hnz1102/EEW-display/hw/BOM.csv

Reference | Qty | Value | DNP | Footprint | digikey/other
C1,C10 | 2 | 1uF |  | Capacitor_SMD:C_0805_2012Metric | 1276-1026-1-ND
C2,C3 | 2 | 16pF |  | Capacitor_SMD:C_0603_1608Metric | 1292-1490-1-ND
C4,C5,C8,C11 | 4 | 0.1uF |  | Capacitor_SMD:C_0603_1608Metric | 311-1344-1-ND
C6,C9 | 2 | 10uF |  | Capacitor_SMD:C_0805_2012Metric | 1276-1096-1-ND
C7 | 1 | 4.7uF |  | Capacitor_SMD:C_0805_2012Metric | 1276-1244-1-ND
D1 | 1 | LED RED |  | LED_SMD:LED_0603_1608Metric | 3147-B1931URO-20D000114U1930CT-ND
D2 | 1 | LED GREEN |  | LED_SMD:LED_0603_1608Metric | 3147-B1911PG--20D000514U1930CT-ND
D3 | 1 | CUS10F30 |  | Diode_SMD:D_SOD-323 | CUS10F30H3FCT-ND
FB1 | 1 | MH2029-601Y |  | Inductor_SMD:L_0805_2012Metric | MH2029-601YCT-ND
J1 | 1 | USB4105-GF-A |  | Library:USB_C_5077CR-16-SMC2-BK-TR | 2073-USB4105-GF-ACT-ND
J2 | 1 | B2B-PH-K-S |  | Connector_JST:JST_PH_B2B-PH-K_1x02_P2.00mm_Vertical | 455-1704-ND
LS1 | 1 | Speaker_UM1515IA |  | Library:Speaker_UM1515IA | https://akizukidenshi.com/catalog/g/g106707/
Q1 | 1 | SSM3J332R |  | Package_TO_SOT_SMD:SOT-23 | 4518-SSM3J332RCT-ND
R1,R2,R7 | 3 | 20K 1% |  | Resistor_SMD:R_0603_1608Metric | 311-20.0KHRCT-ND
R3 | 1 | 10K |  | Resistor_SMD:R_0603_1608Metric | 13-RC0603JR-1010KLCT-ND
R4,R5 | 2 | 5.1K |  | Resistor_SMD:R_0603_1608Metric | 311-5.1KGRCT-ND
R6 | 1 | 2K |  | Resistor_SMD:R_0603_1608Metric | 311-2.0KGRCT-ND
R8 | 1 | 12K 1% |  | Resistor_SMD:R_0603_1608Metric | 311-12.0KCRT-ND
R9,R10 | 2 | 330 |  | Resistor_SMD:R_0603_1608Metric | 13-RC0603JR-13330RLCT-ND
R11 | 1 | 100K |  | Resistor_SMD:R_0603_1608Metric | 311-100KGRCT-ND
R12,R13 | 2 | 100K/0 |  | Resistor_SMD:R_0603_1608Metric | 311-1.00KHRCT-ND
SW1 | 1 | PAGE/BOOT |  | Button_Switch_THT:SW_PUSH_6mm_H8mm | 2223-TS02-66-70-BK-160-LCR-D-ND
SW2 | 1 | ZOOM-IN |  | Button_Switch_THT:SW_PUSH_6mm_H8mm | 2223-TS02-66-70-BK-160-LCR-D-ND
SW3 | 1 | MODE |  | Button_Switch_THT:SW_PUSH_6mm_H8mm | 2223-TS02-66-70-BK-160-LCR-D-ND
SW4 | 1 | ZOOM-OUT |  | Button_Switch_THT:SW_PUSH_6mm_H8mm | 2223-TS02-66-70-BK-160-LCR-D-ND
SW5 | 1 | SLIDE_SW |  | Library:SLIDE_SW_IS1235-G | SLIDE_SW_IS1235-G https://akizukidenshi.com/catalog/g/g115368/
U1 | 1 | ESP32-S3-WROOM-1-N16R8 |  | Library:ESP32-S3-WROOM-1_EXP | 1965-ESP32-S3-WROOM-1-N16R8CT-ND
U2 | 1 | MCP73831T-2ATI/OT |  | Package_TO_SOT_SMD:SOT-23-5 | MCP73831T-2ATI/OTCT-ND
U3 | 1 | SPX3819M5-L |  | Package_TO_SOT_SMD:SOT-23-5 | 1016-1871-1-ND
U4 | 1 | MAX98357A |  | Library:TQFN-16-1EP_3x3mm_P0.5mm_EP1.23x1.23mm | MAX98357AETE+TCT-ND
U5 | 1 | ILI9488 MCU I8080 8/16BIT 3/4 |  | Library:ILI9488 MCU I8080 | -
Y1 | 1 | 32.7680KHz |  | Crystal:Crystal_SMD_3215-2Pin_3.2x1.5mm | 2151-RT3215-32.768-12.5-TRCT-ND
