hnz1102/EEW-display/hw/production/bom.csv

Designator | Footprint | Quantity | Value | LCSC Part #
C1, C10 | 0805 | 2 | 1uF
C11, C4, C5, C8 | 0603 | 4 | 0.1uF
C2, C3 | 0603 | 2 | 16pF
C6, C9 | 0805 | 2 | 10uF
C7 | 0805 | 1 | 4.7uF
D1 | 0603 | 1 | LED RED
D2 | 0603 | 1 | LED GREEN
D3 | D_SOD-323 | 1 | CUS10F30
FB1 | 0805 | 1 | MH2029-601Y
J1 | USB_C_5077CR-16-SMC2-BK-TR | 1 | USB4105-GF-A
J2 | JST_PH_B2B-PH-K_1x02_P2.00mm_Vertical | 1 | B2B-PH-K-S
LS1 | Speaker_UM1515IA | 1 | Speaker_UM1515IA
Q1 | SOT-23 | 1 | SSM3J332R
R1, R2, R7 | 0603 | 3 | 20K 1%
R10, R9 | 0603 | 2 | 330
R11 | 0603 | 1 | 100K
R12, R13 | 0603 | 2 | 100K/0
R3 | 0603 | 1 | 10K
R4, R5 | 0603 | 2 | 5.1K
R6 | 0603 | 1 | 2K
R8 | 0603 | 1 | 12K 1%
SW1 | SW_PUSH_6mm_H8mm | 1 | PAGE/BOOT
SW2 | SW_PUSH_6mm_H8mm | 1 | ZOOM-IN
SW3 | SW_PUSH_6mm_H8mm | 1 | MODE
SW4 | SW_PUSH_6mm_H8mm | 1 | ZOOM-OUT
SW5 | SLIDE_SW_IS1235-G | 1 | SLIDE_SW
U1 | ESP32-S3-WROOM-1_EXP | 1 | ESP32-S3-WROOM-1-N16R8
U2 | SOT-23-5 | 1 | MCP73831T-2ATI/OT
U3 | SOT-23-5 | 1 | SPX3819M5-L
U4 | TQFN-16-1EP_3x3mm_P0.5mm_EP1.23x1.23mm | 1 | MAX98357A
U5 | ILI9488 MCU I8080 | 1 | ILI9488 MCU I8080 8/16BIT 3/4
Y1 | Crystal_SMD_3215-2Pin_3.2x1.5mm | 1 | 32.7680KHz
