hnz1102/EEW-display/STL/base-v4.stl

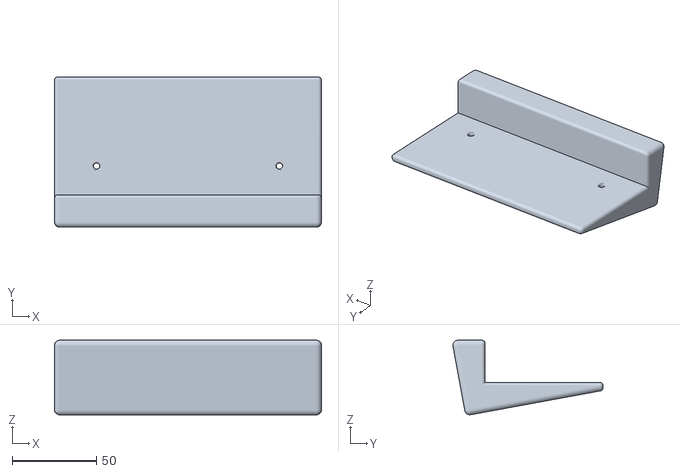
[picture p18: CAD file, 2026-11-04]
STL/base-v4.stl
158.5 x 89.2 x 44.3
