hnz1102/EEW-display/STL/body-v4.stl

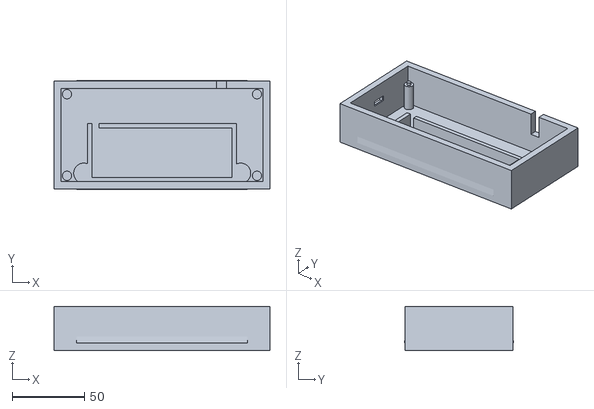
[picture p19: CAD file, 2026-11-04]
STL/body-v4.stl
149.4 x 75.4 x 30.5
