hnz1102/EEW-display/STL/cover-v4.stl

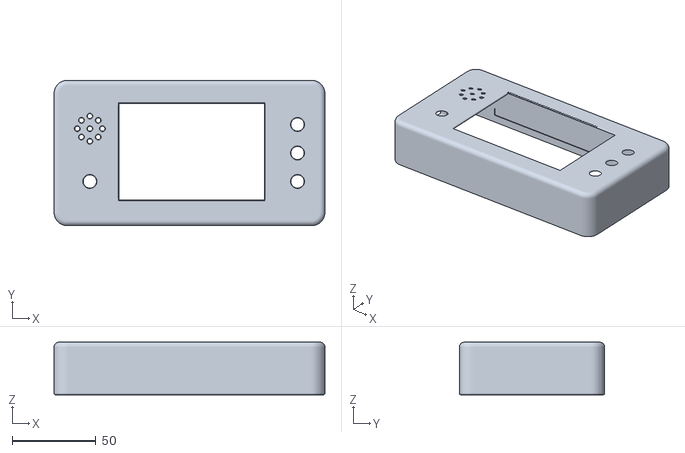
[picture p20: CAD file, 2026-11-04]
STL/cover-v4.stl
161.8 x 86.8 x 31.5
