hnz1102/EEW-display/STL/button.stl

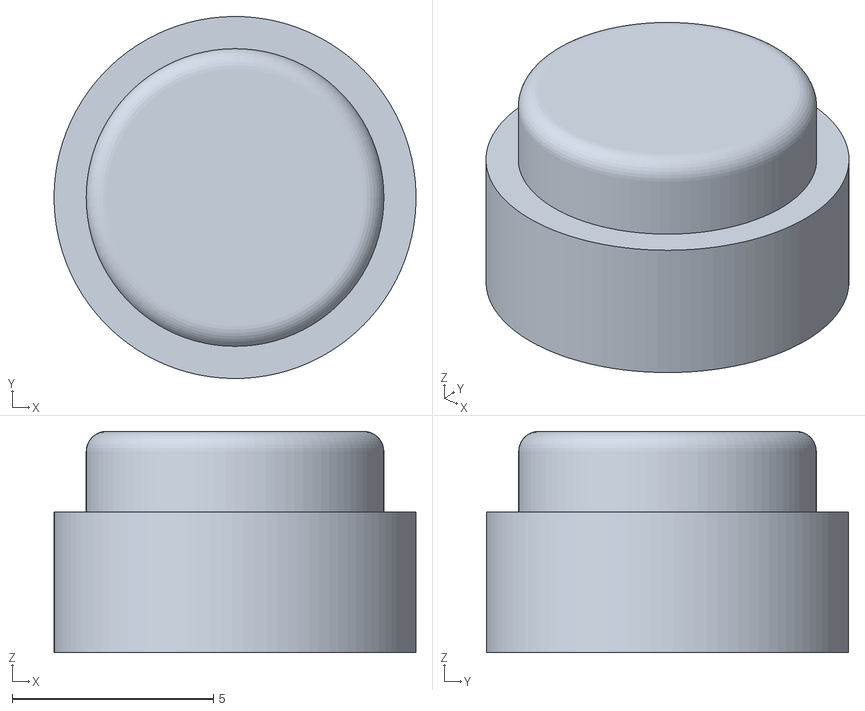
[picture p21: CAD file, 2026-11-04]
STL/button.stl
9.00 x 9.00 x 5.50
