hnz1102/EEW-display/(list of files, cad)

Other CAD files:
STL/eew-display.f3d
