hnz1102/EEW-display/docs/images/test-bench.jpg

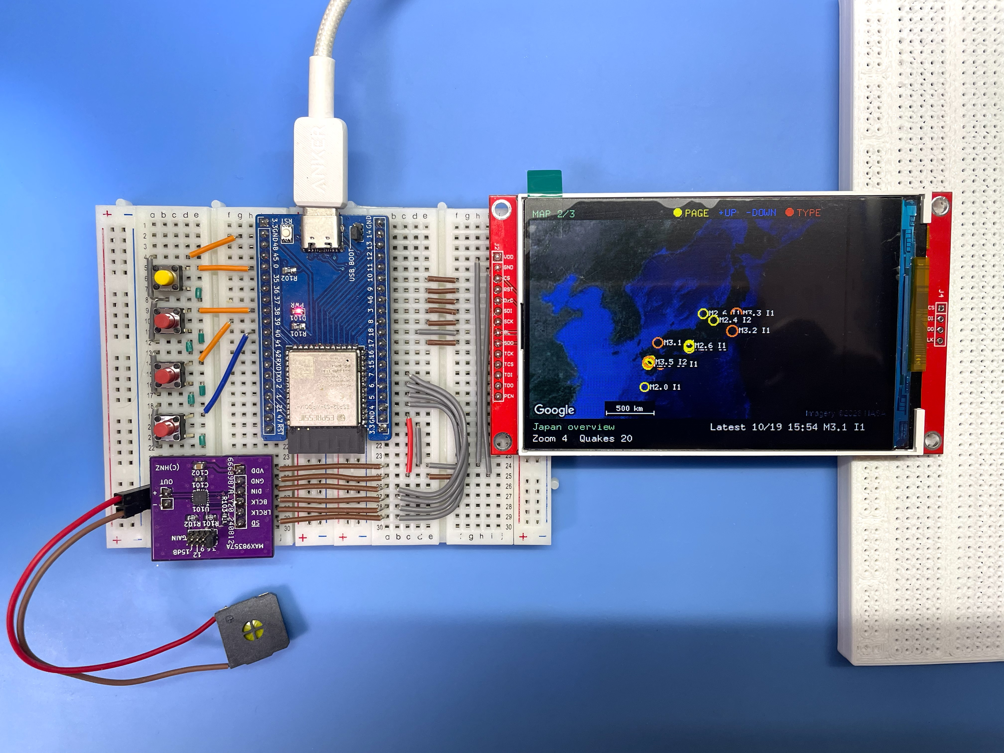
docs/images/test-bench.jpg
