hnz1102/EEW-display/hw/schematic.pdf

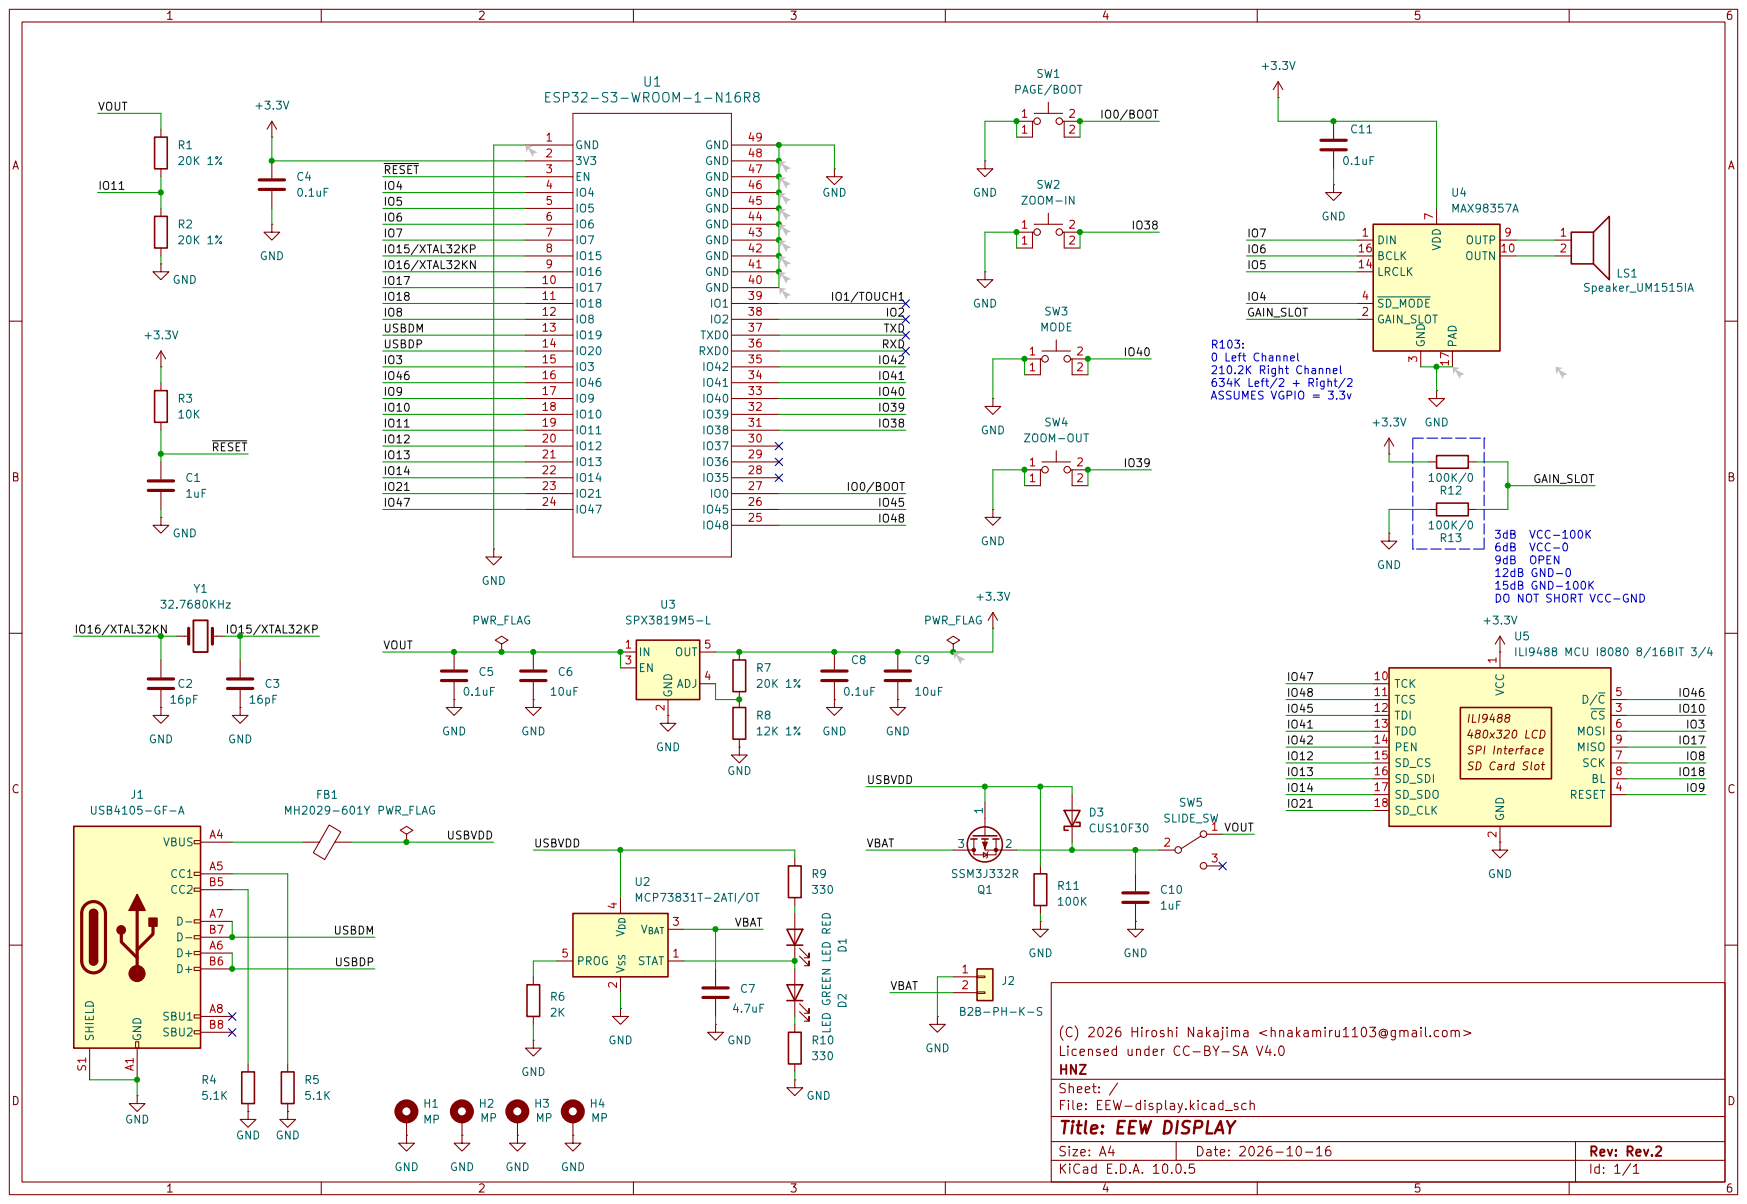
[picture p23: page 1]
