hnz1102/EEW-display/hw/EEW-display.kicad_pcb

## KiCad design hw/EEW-display.kicad_pcb (2026-10-26)

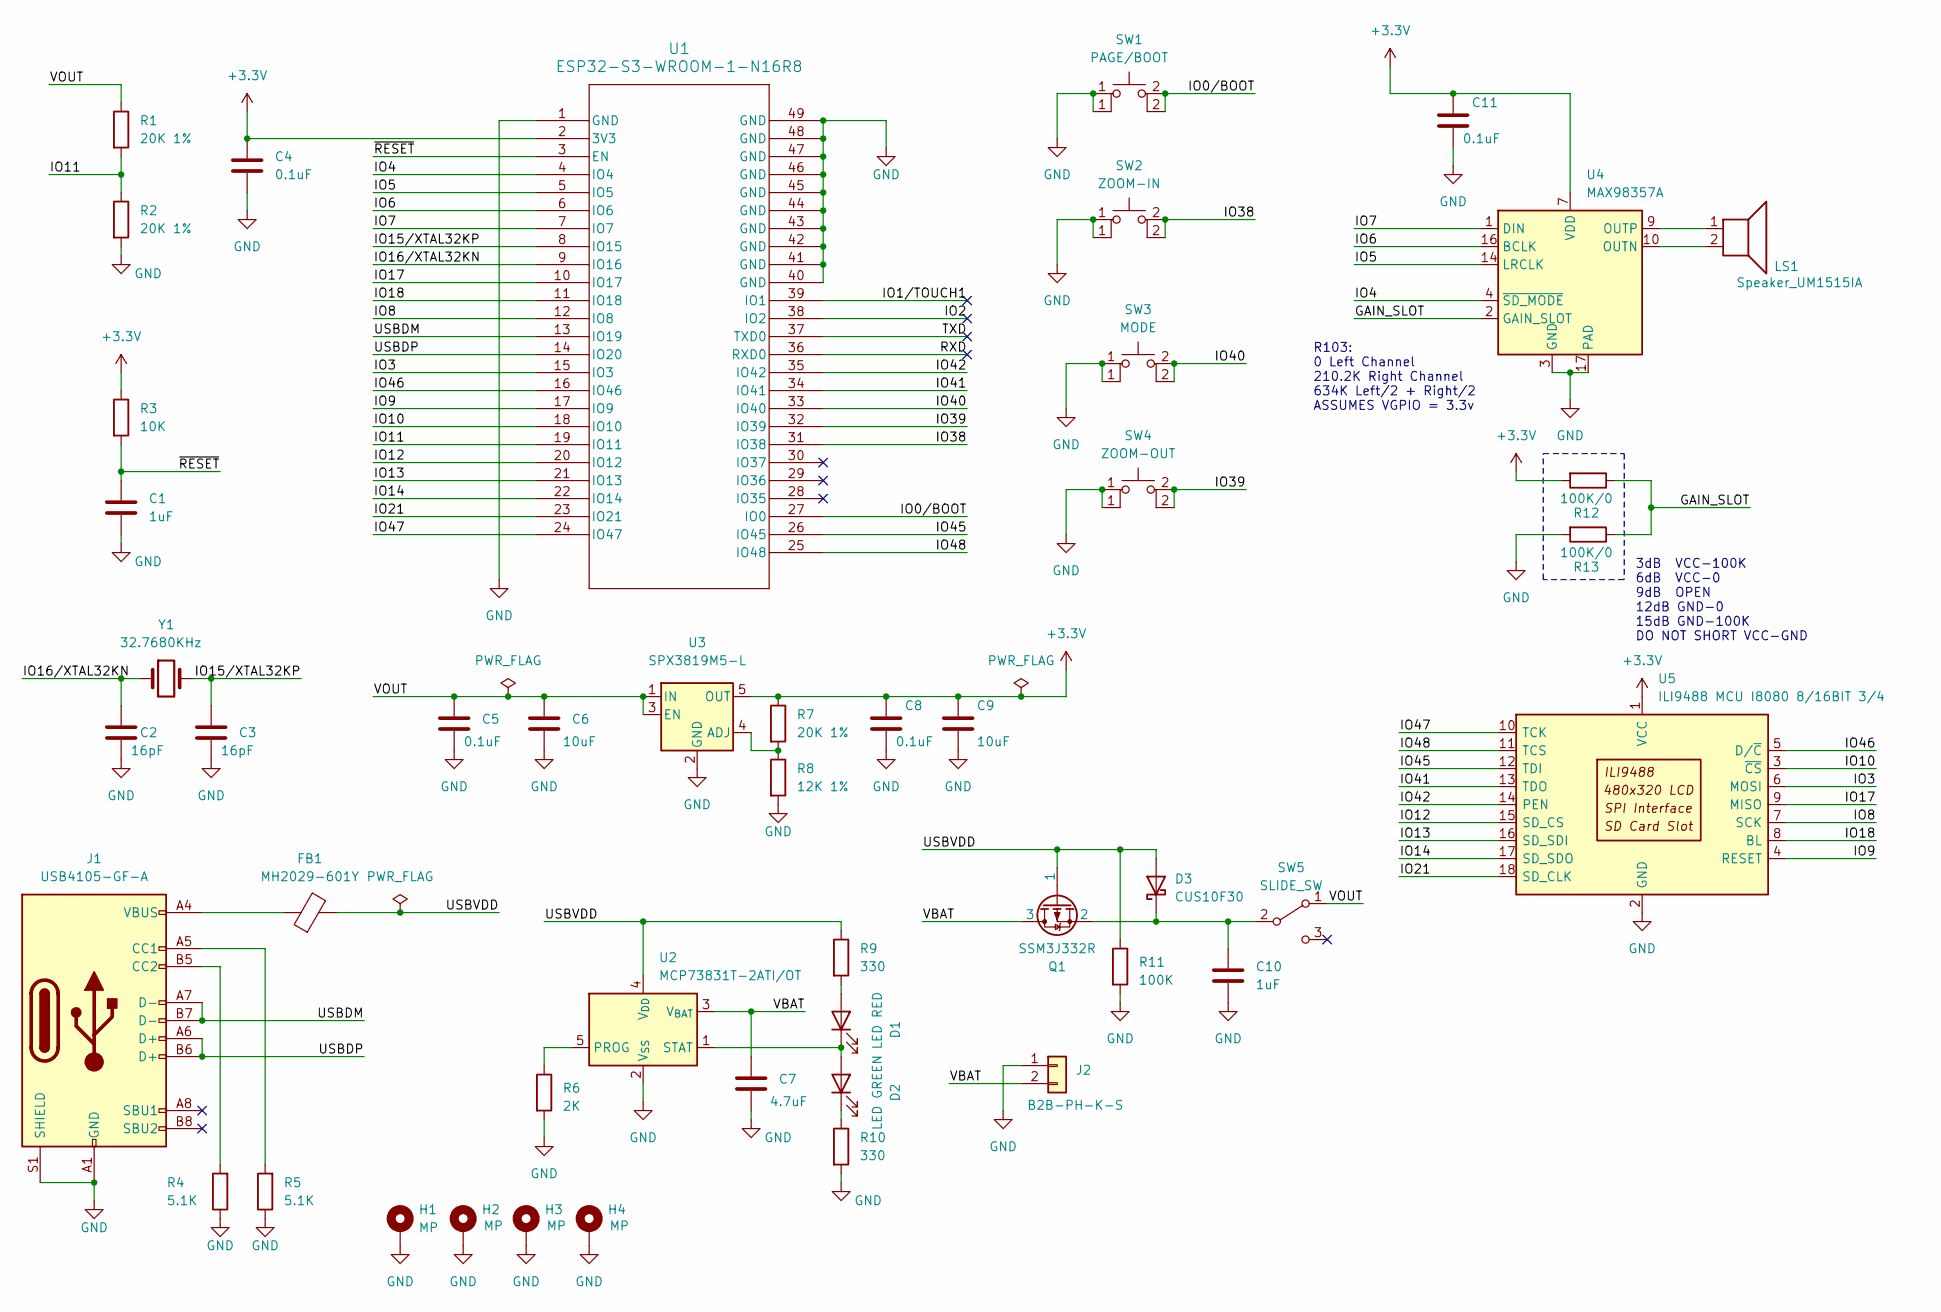
[picture p24: schematic EEW-display.kicad_sch, EEW DISPLAY]

Parts:
C1, C10: 1uF; C_0805_2012Metric; digikey 1276-1026-1-ND
C2, C3: 16pF; C_0603_1608Metric; digikey 1292-1490-1-ND
C4, C5, C8, C11: 0.1uF; C_0603_1608Metric; digikey 311-1344-1-ND
C6, C9: 10uF; C_0805_2012Metric; digikey 1276-1096-1-ND
C7: 4.7uF; C_0805_2012Metric; digikey 1276-1244-1-ND
D1: LED RED; LED_0603_1608Metric; digikey 3147-B1931URO-20D000114U1930CT-ND
D2: LED GREEN; LED_0603_1608Metric; digikey 3147-B1911PG--20D000514U1930CT-ND
D3: CUS10F30; D_SOD-323; digikey CUS10F30H3FCT-ND
FB1: MH2029-601Y; L_0805_2012Metric; digikey MH2029-601YCT-ND
H1, H2, H3, H4: MP; MountingHole_3.2mm_M3_Pad_Via
J1: USB4105-GF-A; USB_C_5077CR-16-SMC2-BK-TR; digikey 2073-USB4105-GF-ACT-ND
J2: B2B-PH-K-S; JST_PH_B2B-PH-K_1x02_P2.00mm_Vertical; digikey 455-1704-ND
LS1: Speaker_UM1515IA
Q1: SSM3J332R; SOT-23; digikey 4518-SSM3J332RCT-ND
R1, R2, R7: 20K 1%; R_0603_1608Metric; digikey 311-20.0KHRCT-ND
R3: 10K; R_0603_1608Metric; digikey 13-RC0603JR-1010KLCT-ND
R4, R5: 5.1K; R_0603_1608Metric; digikey 311-5.1KGRCT-ND
R6: 2K; R_0603_1608Metric; digikey 311-2.0KGRCT-ND
R8: 12K 1%; R_0603_1608Metric; digikey 311-12.0KCRT-ND
R9, R10: 330; R_0603_1608Metric; digikey 13-RC0603JR-13330RLCT-ND
R11: 100K; R_0603_1608Metric; digikey 311-100KGRCT-ND
R12, R13: 100K/0; R_0603_1608Metric; digikey 311-1.00KHRCT-ND
SW1: PAGE/BOOT; SW_PUSH_6mm_H8mm; digikey 2223-TS02-66-70-BK-160-LCR-D-ND
SW2: ZOOM-IN; SW_PUSH_6mm_H8mm; digikey 2223-TS02-66-70-BK-160-LCR-D-ND
SW3: MODE; SW_PUSH_6mm_H8mm; digikey 2223-TS02-66-70-BK-160-LCR-D-ND
SW4: ZOOM-OUT; SW_PUSH_6mm_H8mm; digikey 2223-TS02-66-70-BK-160-LCR-D-ND
SW5: SLIDE_SW; SLIDE_SW_IS1235-G; digikey SLIDE_SW_IS1235-G https://akizukidenshi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
U1: ESP32-S3-WROOM-1-N16R8; ESP32-S3-WROOM-1_EXP; digikey 1965-ESP32-S3-WROOM-1-N16R8CT-ND
U2: MCP73831T-2ATI/OT; SOT-23-5; digikey MCP73831T-2ATI/OTCT-ND
U3: SPX3819M5-L; SOT-23-5; digikey 1016-1871-1-ND
U4: MAX98357A; TQFN-16-1EP_3x3mm_P0.5mm_EP1.23x1.23mm; digikey MAX98357AETE+TCT-ND
U5: ILI9488 MCU I8080 8/16BIT 3/4; ILI9488 MCU I8080
Y1: 32.7680KHz; Crystal_SMD_3215-2Pin_3.2x1.5mm; digikey 2151-RT3215-32.768-12.5-TRCT-ND

Connections:
+3.3V: C4.1, C8.1, C9.1, C11.1, R3.1, R7.1, R12.2, U1.2 (3V3), U3.5 (OUT), U4.7 (VDD), U4.8 (VDD), U5.1 (VCC)
/GAIN_SLOT: R12.1, R13.1, U4.2 (GAIN_SLOT)
/IO0/BOOT: SW1.2, U1.27 (IO0)
/IO1/TOUCH1: U1.39 (IO1)
/IO2: U1.38 (IO2)
/IO3: U1.15 (IO3), U5.6 (MOSI)
/IO4: U1.4 (IO4), U4.4 (~SD_MODE)
/IO5: U1.5 (IO5), U4.14 (LRCLK)
/IO6: U1.6 (IO6), U4.16 (BCLK)
/IO7: U1.7 (IO7), U4.1 (DIN)
/IO8: U1.12 (IO8), U5.7 (SCK)
/IO9: U1.17 (IO9), U5.4 (RESET)
/IO10: U1.18 (IO10), U5.3 (~CS)
/IO11: R1.2, R2.1, U1.19 (IO11)
/IO12: U1.20 (IO12), U5.15 (SD_CS)
/IO13: U1.21 (IO13), U5.16 (SD_SDI)
/IO14: U1.22 (IO14), U5.17 (SD_SDO)
/IO15/XTAL32KP: C3.1, U1.8 (IO15), Y1.2
/IO16/XTAL32KN: C2.1, U1.9 (IO16), Y1.1
/IO17: U1.10 (IO17), U5.9 (MISO)
/IO18: U1.11 (IO18), U5.8 (BL)
/IO21: U1.23 (IO21), U5.18 (SD_CLK)
/IO38: SW2.2, U1.31 (IO38)
/IO39: SW4.2, U1.32 (IO39)
/IO40: SW3.2, U1.33 (IO40)
/IO41: U1.34 (IO41), U5.13 (TDO)
/IO42: U1.35 (IO42), U5.14 (PEN)
/IO45: U1.26 (IO45), U5.12 (TDI)
/IO46: U1.16 (IO46), U5.5 (D/~C)
/IO47: U1.24 (IO47), U5.10 (TCK)
/IO48: U1.25 (IO48), U5.11 (TCS)
/RXD: U1.36 (RXD0)
/TXD: U1.37 (TXD0)
/USBDM: J1.A7 (D-), J1.B7 (D-), U1.13 (IO19)
/USBDP: J1.A6 (D+), J1.B6 (D+), U1.14 (IO20)
/USBVDD: D3.2 (A), FB1.2, Q1.1, R9.1, R11.1, U2.4 (V_{DD})
/VBAT: C7.1, J2.2, Q1.3, U2.3 (V_{BAT})
/VOUT: C5.1, C6.1, R1.1, SW5.1 (A), U3.1 (IN), U3.3 (EN)
/~RESET: C1.1, R3.2, U1.3 (EN)
GND: C1.2, C2.2, C3.2, C4.2, C5.2, C6.2, C7.2, C8.2, C9.2, C10.2, C11.2, H1.1 (1_1), H2.1 (1_1), H3.1 (1_1), H4.1 (1_1), J1.A1 (GND), J1.A12 (GND), J1.B1 (GND), J1.B12 (GND), J1.S1 (SHIELD), J2.1, R2.2, R4.1, R5.1, R6.2, R8.2, R10.2, R11.2, R13.2, SW1.1, SW2.1, SW3.1, SW4.1, U1.1 (GND), U1.40 (GND), U1.41 (GND), U1.42 (GND), U1.43 (GND), U1.44 (GND), U1.45 (GND), U1.46 (GND), U1.47 (GND), U1.48 (GND), U1.49 (GND), U2.2 (V_{SS}), U3.2 (GND), U4.3 (GND), U4.11 (GND), U4.15 (GND), U4.17 (PAD), U5.2 (GND)
unnamed: D1.2 (A), R9.2
unnamed: D1.1 (K), D2.2 (A), U2.1 (STAT)
unnamed: D2.1 (K), R10.1
unnamed: C10.1, D3.1 (K), Q1.2, SW5.2 (B)
unnamed: FB1.1, J1.A4 (VBUS), J1.A9 (VBUS), J1.B4 (VBUS), J1.B9 (VBUS)
unnamed: J1.A5 (CC1), R5.2
unnamed: J1.B5 (CC2), R4.2
unnamed: R6.1, U2.5 (PROG)
unnamed: R7.2, R8.1, U3.4 (ADJ)
unnamed: LS1.2, U4.10 (OUTN)
unnamed: LS1.1, U4.9 (OUTP)

Notes on the sheet:
R103: 0 Left Channel 210.2K Right Channel 634K Left/2 + Right/2 ASSUMES VGPIO = 3.3v
3dB VCC-100K 6dB VCC-0 9dB OPEN 12dB GND-0 15dB GND-100K DO NOT SHORT VCC-GND

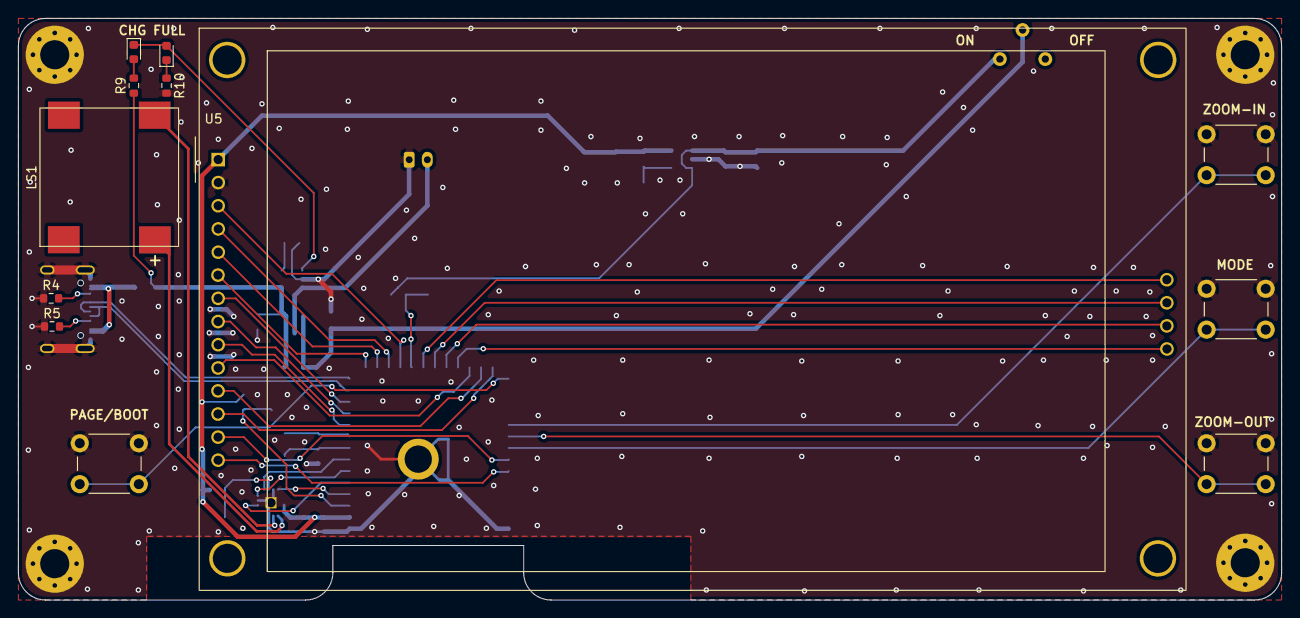
[picture p25: board EEW-display.kicad_pcb from above]

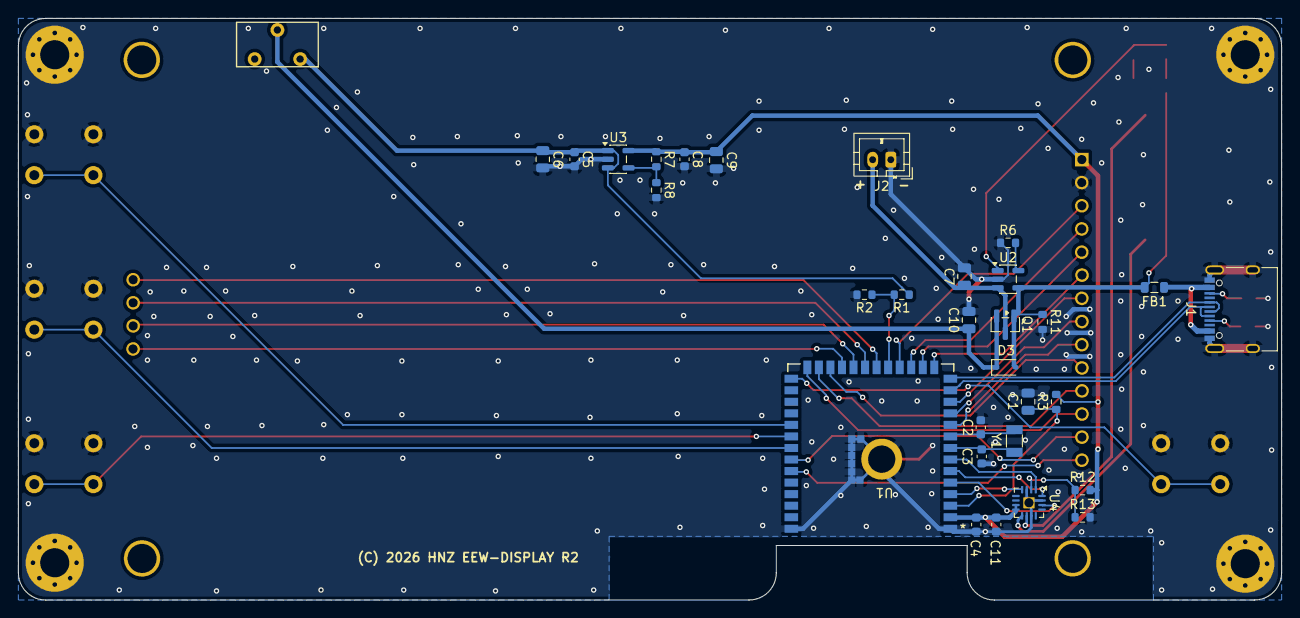
[picture p26: board EEW-display.kicad_pcb from below]

Board: 2 copper layers, 139.0 x 64.0 mm, 47 parts (31 on the bottom side), 47 nets.
