hnz1102/EEW-display/src/display_pages.rs

//! Page rendering for the TFT (ILI9488, 480x320 landscape, RGB565 framebuffer).
//! Everything here is generic over `DrawTarget`, with no ESP-IDF dependency, so
//! `tools/screenshots` can compile this file on the host and render each page
//! to a PNG.
//!
//! Pages: EARTHQUAKE (recent list) → MAP (epicenters / EEW) → INFO → ...
use std::sync::Mutex;
use core::sync::atomic::{AtomicU8, Ordering};
use embedded_graphics::{
    mono_font::{ascii::FONT_6X12, ascii::FONT_8X13, ascii::FONT_10X20, MonoTextStyle, MonoTextStyleBuilder},
    pixelcolor::Rgb565,
    text::Text,
    geometry::{Point, Size},
    primitives::{Circle, Line, Rectangle, PrimitiveStyle, PrimitiveStyleBuilder},
    prelude::*,
};

/// Screen size in pixels.
pub(crate) const SCREEN_W: i32 = 480;
pub(crate) const SCREEN_H: i32 = 320;
/// Header height in pixels.
pub(crate) const HEADER_H: i32 = 28;
/// The button legend row at the bottom of every page.
pub(crate) const LEGEND_Y: i32 = SCREEN_H - 24;
/// Info rows use FONT_8X13 on this pitch.
const INFO_ROW_H: i32 = 18;
const INFO_CHAR_W: i32 = 8;

// ─── Display page management ─────────────────────────────────────────────
// Page order: QUAKE(0) → MAP(1) → INFO(2) → QUAKE ...
pub const PAGE_QUAKE: u8 = 0;
pub const PAGE_MAP:   u8 = 1;
pub const PAGE_INFO:  u8 = 2;
pub(crate) const PAGE_COUNT: u8 = 3;

pub(crate) static CURRENT_PAGE: AtomicU8 = AtomicU8::new(PAGE_MAP);

pub fn next_page() {
    let cur = CURRENT_PAGE.load(Ordering::Relaxed);
    CURRENT_PAGE.store((cur + 1) % PAGE_COUNT, Ordering::SeqCst);
}

pub fn set_page(page: u8) {
    if page < PAGE_COUNT {
        CURRENT_PAGE.store(page, Ordering::SeqCst);
    }
}

pub fn current_page() -> u8 {
    CURRENT_PAGE.load(Ordering::Relaxed)
}

// ─── System message overlay (for important notifications) ────────────────
pub(crate) static SYSTEM_MESSAGE: Mutex<Option<(String, String)>> = Mutex::new(None);

/// Display a system message overlay (title + text).
pub fn show_system_message(title: &str, text: &str) {
    *SYSTEM_MESSAGE.lock().unwrap() = Some((title.to_string(), text.to_string()));
}

/// Clear the system message overlay.
pub fn clear_system_message() {
    *SYSTEM_MESSAGE.lock().unwrap() = None;
}

// ─── Shared info for Info page (set from main after init) ────────────────
pub struct DisplayAux {
    pub status: crate::httpserver::StatusInfo,
}

pub(crate) static DISPLAY_AUX: Mutex<Option<DisplayAux>> = Mutex::new(None);

pub fn set_display_aux(aux: DisplayAux) {
    *DISPLAY_AUX.lock().unwrap() = Some(aux);
}

// ─── Small helpers ───────────────────────────────────────────────────────

const DIM: Rgb565 = Rgb565::new(10, 21, 10);
const CYAN: Rgb565 = Rgb565::new(0, 50, 31);
const SEL_BG: Rgb565 = Rgb565::new(1, 10, 14);

fn fill<D: DrawTarget<Color = Rgb565>>(display: &mut D, x: i32, y: i32, w: i32, h: i32, c: Rgb565) {
    let _ = Rectangle::new(Point::new(x, y), Size::new(w.max(0) as u32, h.max(0) as u32))
        .into_styled(PrimitiveStyle::with_fill(c))
        .draw(display);
}

fn text<D: DrawTarget<Color = Rgb565>>(
    display: &mut D, s: &str, x: i32, baseline: i32, font: &'static embedded_graphics::mono_font::MonoFont<'static>, c: Rgb565,
) {
    let _ = Text::new(s, Point::new(x, baseline), MonoTextStyle::new(font, c)).draw(display);
}

/// "35.70N 140.85E"
fn fmt_latlon(lat: f64, lon: f64) -> String {
    format!("{:.2}{} {:.2}{}",
        lat.abs(), if lat >= 0.0 { 'N' } else { 'S' },
        lon.abs(), if lon >= 0.0 { 'E' } else { 'W' })
}

fn fmt_mag(mag: f32) -> String {
    if mag >= 0.0 { format!("M{:.1}", mag) } else { "M?".into() }
}

fn fmt_depth(depth: i32) -> String {
    match depth { d if d < 0 => "?km".to_string(), 0 => "0km".to_string(), d => format!("{}km", d) }
}

/// Epicenter marker / list colour by max seismic intensity (falls back to magnitude).
fn quake_color(scale: i32, mag: f32) -> Rgb565 {
    let m = if mag > 0.0 { mag } else { 1.0 };
    if scale >= 55 { Rgb565::new(31, 0, 31) }              // 6- and up: magenta
    else if scale >= 45 || m >= 5.0 { Rgb565::RED }        // 5- / 5+
    else if scale >= 30 || m >= 3.0 { Rgb565::CSS_ORANGE }
    else { Rgb565::YELLOW }
}

// ─── Battery icon ────────────────────────────────────────────────────────

/// Battery level: `BATT_NONE` = no reading, `BATT_USB` = externally powered
/// (voltage >= 4.5 V), 0..=5 = number of lit segments.
pub(crate) const BATT_NONE: u8 = 255;
pub(crate) const BATT_USB: u8 = 254;
pub(crate) const USB_ENTER_V: f32 = 4.50;
pub(crate) const USB_EXIT_V: f32 = 4.45;
pub(crate) const BATT_SEGS: u8 = 5;

pub(crate) fn battery_voltage() -> f32 {
    DISPLAY_AUX.lock().unwrap().as_ref()
        .map(|aux| *aux.status.battery_voltage.lock().unwrap())
        .unwrap_or(0.0)
}

/// Single-cell Li-ion thresholds with hysteresis (same steps as wakepcbox),
/// so the icon doesn't flicker when the voltage hovers near a boundary.
pub(crate) fn next_battery_level(prev: u8, v: f32) -> u8 {
    const UP:   [f32; 5] = [3.75, 3.85, 3.95, 4.00, 4.05]; // level k -> k+1
    const DOWN: [f32; 5] = [3.70, 3.80, 3.90, 3.95, 4.00]; // level k+1 -> k
    if v < 2.0 { return BATT_NONE; }          // no battery / not measured
    if prev == BATT_USB {
        if v >= USB_EXIT_V { return BATT_USB; }
        return UP.iter().filter(|&&t| v > t).count() as u8;
    }
    if v >= USB_ENTER_V { return BATT_USB; }
    if prev == BATT_NONE || prev > BATT_SEGS {
        // First reading: pick the level directly
        return UP.iter().filter(|&&t| v > t).count() as u8;
    }
    let mut lvl = prev;
    if (lvl as usize) < UP.len() && v > UP[lvl as usize] { lvl += 1; }
    else if lvl > 0 && v < DOWN[lvl as usize - 1] { lvl -= 1; }
    lvl
}

/// `compact`: draw into the one-line top bar of the MAP page (MAP_BAR_H high)
/// instead of the normal HEADER_H-high header.
pub(crate) fn draw_battery_icon<D: DrawTarget<Color = Rgb565>>(display: &mut D, level: u8, compact: bool) {
    const X: i32 = SCREEN_W - 34;
    let (bar_h, y0) = if compact { (MAP_BAR_H, 4) } else { (HEADER_H, 8) };
    const BODY_W: u32 = 26;
    const BODY_H: u32 = 12;
    // Clear the icon area (header background)
    fill(display, X - 2, 0, SCREEN_W - (X - 2), bar_h, Rgb565::BLACK);
    if level == BATT_NONE { return; }
    if level == BATT_USB {
        text(display, "USB", X + 4, y0 + 10, &FONT_6X12, Rgb565::CSS_CYAN);
        return;
    }
    let color = match level {
        0 | 1 => Rgb565::CSS_RED,
        2     => Rgb565::CSS_ORANGE,
        _     => Rgb565::CSS_LIGHT_GREEN,
    };
    // Body outline + terminal tip
    let _ = Rectangle::new(Point::new(X, y0), Size::new(BODY_W, BODY_H))
        .into_styled(PrimitiveStyle::with_stroke(Rgb565::WHITE, 1))
        .draw(display);
    fill(display, X + BODY_W as i32, y0 + 3, 2, BODY_H as i32 - 6, Rgb565::WHITE);
    // Segments (4 px wide, 1 px gap)
    for i in 0..level.min(BATT_SEGS) as i32 {
        fill(display, X + 2 + i * 5, y0 + 2, 4, BODY_H as i32 - 4, color);
    }
}

// ─── Wi-Fi / WebSocket status icons (top-right of every page, left of the battery) ───

/// Current link state for the status icons: (Wi-Fi, WebSocket).
/// Wi-Fi: 0 = no connection / IP, 1..=4 = signal bars. WebSocket: 0 = the quake
/// feed is switched off, 1 = down (reconnecting), 2 = connected.
pub(crate) fn net_status() -> (u8, u8) {
    let wifi = if !crate::wifi::net_up() {
        0
    } else {
        let rssi = DISPLAY_AUX.lock().unwrap().as_ref()
            .map(|aux| *aux.status.rssi.lock().unwrap())
            .unwrap_or(0);
        match rssi { r if r >= -55 => 4, r if r >= -67 => 3, r if r >= -75 => 2, _ => 1 }
    };
    let ws = if !crate::quake::enabled() { 0 } else if crate::quake::ws_connected() { 2 } else { 1 };
    (wifi, ws)
}

/// Horizontal room the icons take, ending before the battery (which clears from
/// SCREEN_W - 36).
const STATUS_X: i32 = SCREEN_W - 36 - 44;
const STATUS_W: i32 = 44;

/// A chain link (two interlocked capsules on the diagonal), 16 × 16, '#' = set.
/// Compiled into flash as a constant: no RAM, nothing to load.
const LINK_ICON: [&str; 16] = [
    "..........#####.",
    ".........#######",
    "........###...##",
    ".......###....##",
    "......###.....##",
    ".....####....###",
    "....######..###.",
    "...####.######..",
    "..######.####...",
    ".###..######....",
    "###....####.....",
    "##.....###......",
    "##....###.......",
    "##...###........",
    "#######.........",
    ".#####..........",
];

/// Draw a '#'-mask at (x, y) in one colour.
fn draw_mask<D: DrawTarget<Color = Rgb565>>(display: &mut D, x: i32, y: i32, mask: &[&str], color: Rgb565) {
    let _ = display.draw_iter(mask.iter().enumerate().flat_map(|(row, line)| {
        line.bytes().enumerate().filter(|&(_, b)| b == b'#')
            .map(move |(col, _)| Pixel(Point::new(x + col as i32, y + row as i32), color))
    }));
}

/// Draw the Wi-Fi (signal bars) and WebSocket (chain link) icons.
/// `compact`: the MAP page's one-line top bar (MAP_BAR_H high) instead of the
/// normal HEADER_H-high header. Wi-Fi: green/yellow/orange bars by strength, all
/// dim with a red slash when there is no connection. WebSocket: green link when
/// connected, orange with a red slash while down and reconnecting, dim grey when
/// the feed is off.
pub(crate) fn draw_status_icons<D: DrawTarget<Color = Rgb565>>(display: &mut D, wifi: u8, ws: u8, compact: bool) {
    let (bar_h, dy) = if compact { (MAP_BAR_H, 0) } else { (HEADER_H, 4) };
    fill(display, STATUS_X, 0, STATUS_W, bar_h, Rgb565::BLACK);

    // Wi-Fi: four bars, 3 px wide, rising 3 px each, bottoms at y = 16 (+dy)
    let wx = STATUS_X + 2;
    let lit = match wifi { 4 | 3 => Rgb565::CSS_LIGHT_GREEN, 2 => Rgb565::YELLOW, _ => Rgb565::CSS_ORANGE };
    for i in 0..4i32 {
        let h = 4 + i * 3;
        let on = wifi > 0 && i < wifi as i32;
        fill(display, wx + i * 4, 16 + dy - h, 3, h, if on { lit } else { Rgb565::new(5, 10, 5) });
    }
    let red = PrimitiveStyle::with_stroke(Rgb565::RED, 2);
    if wifi == 0 {
        let _ = Line::new(Point::new(wx, 3 + dy), Point::new(wx + 14, 17 + dy)).into_styled(red).draw(display);
    }

    // WebSocket: the chain link
    let lx = STATUS_X + 24;
    let ly = 2 + dy;
    let col = match ws { 2 => Rgb565::CSS_LIGHT_GREEN, 1 => Rgb565::CSS_ORANGE, _ => Rgb565::new(10, 20, 10) };
    draw_mask(display, lx, ly, &LINK_ICON, col);
    if ws == 1 {
        let _ = Line::new(Point::new(lx + 1, ly + 1), Point::new(lx + 15, ly + 15)).into_styled(red).draw(display);
    }
}

// ─── System message overlay drawing ──────────────────────────────────────

pub(crate) fn draw_system_message<D: DrawTarget<Color = Rgb565>>(
    display: &mut D,
    title: &str,
    text_body: &str,
    header_style: &MonoTextStyle<Rgb565>,
    force_clear: bool,
) {
    // Only full clear and redraw header on first display or when message changes
    if force_clear {
        let _ = display.clear(Rgb565::BLACK);
        let _ = Text::new(title, Point::new(4, 21), *header_style).draw(display);
        fill(display, 0, HEADER_H, SCREEN_W, 1, Rgb565::CSS_DARK_GREEN);
    }

    // Background colour overwrites the previous text without a clear.
    let msg_style = MonoTextStyleBuilder::new()
        .font(&FONT_10X20)
        .text_color(Rgb565::YELLOW)
        .background_color(Rgb565::BLACK)
        .build();

    let y_start = 110;
    let lines: Vec<&str> = text_body.lines().collect();
    for (i, line) in lines.iter().enumerate() {
        let y = y_start + (i as i32 * 28);
        // Pad to the full width (48 chars of 10 px) so a shorter line erases the old one.
        let padded = format!("{:<48}", line);
        let _ = Text::new(&padded, Point::new(0, y), msg_style).draw(display);
    }
    if !force_clear && lines.len() < 6 {
        for i in lines.len()..6 {
            let y = y_start + (i as i32 * 28);
            let _ = Text::new(&format!("{:<48}", ""), Point::new(0, y), msg_style).draw(display);
        }
    }
}

// ─── Header drawing ──────────────────────────────────────────────────────

pub(crate) fn draw_header<D: DrawTarget<Color = Rgb565>>(
    display: &mut D,
    page: u8,
    style: &MonoTextStyle<Rgb565>,
) {
    let page_num = page + 1;
    let title = match page {
        PAGE_QUAKE => format!("EARTHQUAKE    {}/{}", page_num, PAGE_COUNT),
        PAGE_MAP   => format!("MAP           {}/{}", page_num, PAGE_COUNT),
        PAGE_INFO  => format!("SYSTEM INFO   {}/{}", page_num, PAGE_COUNT),
        _          => format!("PAGE {}        {}/{}", page, page_num, PAGE_COUNT),
    };
    fill(display, 0, 0, SCREEN_W, HEADER_H, Rgb565::BLACK);
    let _ = Text::new(&title, Point::new(4, 21), *style).draw(display);
    fill(display, 0, HEADER_H, SCREEN_W, 1, Rgb565::CSS_DARK_GREEN);
}

// ─── Button legend ───────────────────────────────────────────────────────
//
// Same look on every page so the on-screen hint matches the physical buttons:
// B0 (page) = yellow round button, GPIO38 = blue "+UP", GPIO39 = blue "-DOWN",
// B6 = red round button. Round buttons carry a short label of what they do
// on the current page.

pub(crate) enum Legend {
    /// B0 — yellow round button (page switch / exit).
    Page(&'static str),
    /// GPIO38 — blue "+UP".
    Up,
    /// GPIO39 — blue "-DOWN".
    Down,
    /// B6 — red round button.
    Action(&'static str),
}

const LEGEND_BLUE: Rgb565 = Rgb565::new(8, 28, 31);

/// Draws `items` left to right starting at `x`; `baseline` is the text baseline
/// (FONT_8X13). Returns the x just past the last item.
pub(crate) fn draw_legend<D: DrawTarget<Color = Rgb565>>(
    display: &mut D, x: i32, baseline: i32, items: &[Legend],
) -> i32 {
    let mut x = x;
    for item in items {
        let (color, label, round) = match item {
            Legend::Page(l)   => (Rgb565::YELLOW, *l, true),
            Legend::Action(l) => (Rgb565::RED, *l, true),
            Legend::Up        => (LEGEND_BLUE, "+UP", false),
            Legend::Down      => (LEGEND_BLUE, "-DOWN", false),
        };
        if round {
            let _ = Circle::new(Point::new(x, baseline - 10), 11)
                .into_styled(PrimitiveStyle::with_fill(color)).draw(display);
            x += 15;
        }
        text(display, label, x, baseline, &FONT_8X13, color);
        x += label.len() as i32 * INFO_CHAR_W + 12;
    }
    x
}

/// Clears the legend row and draws `items` on it.
fn draw_legend_row<D: DrawTarget<Color = Rgb565>>(display: &mut D, items: &[Legend], width: i32) {
    fill(display, 0, LEGEND_Y, width, SCREEN_H - LEGEND_Y, Rgb565::BLACK);
    draw_legend(display, 4, LEGEND_Y + 16, items);
}


// ─── Map page ─────────────────────────────────────────────────────────────
//
// A Google Maps Static API JPEG (480x266) between a one-line top bar (title,
// button legend, battery) and a two-column text band at the bottom, centred on
// the earthquake picked on the quake page, on an EEW epicenter, or on a
// Japan-wide overview, with the recent epicenters drawn on it. Nothing is
// drawn over the map except the markers and the scale bar.
// Requires a Maps API key (Web UI / cfg.toml) and WiFi connectivity.

/// One-line top bar of the MAP page: title, button legend, battery.
pub(crate) const MAP_BAR_H: i32 = 20;
const MAP_Y_TOP: i32 = MAP_BAR_H;
const MAP_Y_BOT: i32 = MAP_Y_TOP + crate::map_display::MAP_H as i32;
/// Two-column text band under the map (2 rows of 16 px).
const TEXT_Y: i32 = MAP_Y_BOT;
const TEXT_COL_X: [i32; 2] = [4, SCREEN_W / 2 + 4];

/// Web Mercator projection: (lat, lon) → screen pixel, for a map image of
/// `crate::map_display::MAP_W`×(y_bot−y_top) centred at (clat, clon) at the
/// given zoom. Returns `None` if `clat` is NaN (no map yet) or the point
/// falls outside the visible image.
pub(crate) fn project_to_map(clat: f64, clon: f64, zoom: u8, lat: f64, lon: f64, y_top: i32, y_bot: i32) -> Option<(i32, i32)> {
    if clat.is_nan() { return None; }
    let world = 256.0_f64 * ((1u64 << zoom) as f64);
    let lat_r  = lat.to_radians();
    let clat_r = clat.to_radians();
    let merc_pt  = (lat_r  / 2.0 + core::f64::consts::FRAC_PI_4).tan().ln();
    let merc_cen = (clat_r / 2.0 + core::f64::consts::FRAC_PI_4).tan().ln();
    let dx = (lon - clon) * world / 360.0;
    let dy = -(merc_pt - merc_cen) * world / (2.0 * core::f64::consts::PI);
    let px = (crate::map_display::MAP_W as f64 / 2.0 + dx).round() as i32;
    let py = y_top + ((y_bot - y_top) as f64 / 2.0 + dy).round() as i32;
    if px >= 0 && px < crate::map_display::MAP_W as i32 && py >= y_top && py < y_bot {
        Some((px, py))
    } else {
        None
    }
}

/// Redraws the map page when something changed. Returns true if it drew
/// (the caller then redraws the battery icon, which sits on top of the map).
pub(crate) fn draw_map_page<D: DrawTarget<Color = Rgb565>>(
    display: &mut D,
    force: bool,
    prev_sig: &mut u32,
) -> bool {
    let quake_focus = crate::quake::focus();
    let eew = crate::quake::eew();
    let newq = crate::quake::new_quake();
    let prompt = crate::quake::prompt();

    // Where the map should be centred: the focused epicenter, else the Japan overview.
    let (want_lat, want_lon) = match quake_focus {
        Some((la, lo)) => (la, lo),
        None => (crate::map_display::DEFAULT_VIEW.0, crate::map_display::DEFAULT_VIEW.1),
    };
    crate::map_display::trigger(want_lat, want_lon);

    let map_ver = crate::map_display::version();
    let has     = crate::map_display::has_map();
    let busy    = crate::map_display::is_busy();

    // ── Change detection ─────────────────────────────────────────────────────
    let map_sig = map_ver
        .wrapping_mul(31)
        .wrapping_add(if busy { 1 } else { 0 })
        .wrapping_add((crate::map_display::get_zoom() as u32).wrapping_mul(5))
        .wrapping_add(crate::quake::version().wrapping_mul(13))
        .wrapping_add(crate::quake::eew_version().wrapping_mul(17))
        .wrapping_add(crate::quake::newq_version().wrapping_mul(19))
        .wrapping_add(if quake_focus.is_some() { 23 } else { 0 });
    if !force && map_sig == *prev_sig { return false; }
    *prev_sig = map_sig;

    // ── Map background ───────────────────────────────────────────────────────
    let map_rect = Rectangle::new(
        Point::new(0, MAP_Y_TOP),
        Size::new(crate::map_display::MAP_W as u32, crate::map_display::MAP_H as u32),
    );
    if has {
        crate::map_display::with_pixels(|pixels| {
            let _ = display.fill_contiguous(
                &map_rect,
                pixels.iter().map(|&p| Rgb565::new(
                    ((p >> 11) & 0x1F) as u8,
                    ((p >> 5)  & 0x3F) as u8,
                    (p & 0x1F) as u8,
                )),
            );
        });
    } else {
        let _ = map_rect.into_styled(PrimitiveStyle::with_fill(Rgb565::BLACK)).draw(display);
        let msg = if !crate::map_display::has_api_key() {
            "Set Maps API key in Web UI"
        } else if busy {
            "Fetching map..."
        } else {
            "Waiting for map..."
        };
        text(display, msg, 8, MAP_Y_TOP + 130, &FONT_8X13, Rgb565::new(0, 25, 12));
    }

    // ── Overlays ─────────────────────────────────────────────────────────────
    if has {
        let (clat, clon) = crate::map_display::get_map_center();
        // The zoom the displayed image was fetched at, not the current
        // setting — they differ while a refetch after a zoom change is in
        // flight, and everything below is drawn onto that image.
        let zoom = crate::map_display::get_tile_zoom();
        let to_px = |lat: f64, lon: f64| -> Option<(i32, i32)> {
            project_to_map(clat, clon, zoom, lat, lon, MAP_Y_TOP, MAP_Y_BOT)
        };

        // Recent earthquake epicenters that fall inside the visible image.
        let s_q = MonoTextStyleBuilder::new().font(&FONT_6X12)
            .text_color(Rgb565::WHITE).build();
        for q in crate::quake::get().iter() {
            if let Some((qx, qy)) = to_px(q.lat, q.lon) {
                let m = if q.mag > 0.0 { q.mag } else { 1.0 };
                let diam = (6.0 + m * 2.5).clamp(8.0, 30.0) as u32;
                let col = quake_color(q.scale, q.mag);
                let _ = Circle::with_center(Point::new(qx, qy), diam)
                    .into_styled(PrimitiveStyleBuilder::new()
                        .stroke_color(col).stroke_width(2).build())
                    .draw(display);
                // The newly received earthquake gets an extra white ring.
                if newq.as_ref().map(|n| n.time == q.time && n.lat == q.lat && n.lon == q.lon).unwrap_or(false) {
                    let _ = Circle::with_center(Point::new(qx, qy), diam + 12)
                        .into_styled(PrimitiveStyle::with_stroke(Rgb565::WHITE, 1))
                        .draw(display);
                }
                // The epicenter picked on the quake page gets a thin cyan ring.
                if quake_focus.map(|(fl, fo)| (fl - q.lat).abs() < 1e-6 && (fo - q.lon).abs() < 1e-6).unwrap_or(false) {
                    let _ = Circle::with_center(Point::new(qx, qy), diam + 8)
                        .into_styled(PrimitiveStyle::with_stroke(Rgb565::CSS_CYAN, 1))
                        .draw(display);
                }
                // Label: magnitude and max seismic intensity, e.g. "M3.5 I3" / "M5.2 I5-"
                let label = match (q.mag > 0.0, q.scale > 0) {
                    (true, true)  => format!("M{:.1} I{}", q.mag, q.intensity()),
                    (true, false) => format!("M{:.1}", q.mag),
                    (false, true) => format!("I{}", q.intensity()),
                    _ => String::new(),
                };
                if !label.is_empty() {
                    let lx = qx + diam as i32 / 2 + 3;
                    // Keep the label on screen near the right edge.
                    let lx = lx.min(SCREEN_W - label.len() as i32 * 6 - 1);
                    // Dark backing so the text reads over satellite imagery.
                    fill(display, lx - 1, qy - 7, label.len() as i32 * 6 + 2, 13, Rgb565::new(1, 2, 1));
                    let _ = Text::new(&label, Point::new(lx, qy + 3), s_q).draw(display);
                }
            }
        }

        // Active EEW: forecast epicenter drawn as a large red X.
        if let Some(e) = eew.as_ref() {
            if !e.lat.is_nan() {
                if let Some((ex, ey)) = to_px(e.lat, e.lon) {
                    let xs = PrimitiveStyle::with_stroke(Rgb565::RED, 3);
                    let _ = Line::new(Point::new(ex - 11, ey - 11), Point::new(ex + 11, ey + 11)).into_styled(xs).draw(display);
                    let _ = Line::new(Point::new(ex - 11, ey + 11), Point::new(ex + 11, ey - 11)).into_styled(xs).draw(display);
                    let lbl = format!("EEW I{}", e.intensity());
                    let lx = (ex + 14).min(SCREEN_W - lbl.len() as i32 * 6 - 1);
                    fill(display, lx - 1, ey - 7, lbl.len() as i32 * 6 + 2, 13, Rgb565::new(1, 2, 1));
                    text(display, &lbl, lx, ey + 3, &FONT_6X12, Rgb565::RED);
                }
            }
        }

        // ── Scale bar (bottom-left corner of the map) ─────────────────────
        // Web Mercator: metres-per-pixel at current centre latitude
        let lat_cos = if clat.is_nan() { 1.0f64 } else { clat.to_radians().cos() };
        let mpp = (2.0 * core::f64::consts::PI * 6_378_137.0 * lat_cos)
                  / (256.0 * (1u64 << zoom) as f64);

        // Nearest "nice" distance to a target of ~64 px
        const NICE_M: &[f64] = &[
            1.0, 2.0, 5.0, 10.0, 20.0, 50.0,
            100.0, 200.0, 500.0,
            1_000.0, 2_000.0, 5_000.0, 10_000.0,
            20_000.0, 50_000.0, 100_000.0, 200_000.0, 500_000.0, 1_000_000.0,
        ];
        let target_m = mpp * 64.0;
        let nice_m = NICE_M.iter().copied().min_by(|&a, &b| {
            (a - target_m).abs().partial_cmp(&(b - target_m).abs())
                .unwrap_or(core::cmp::Ordering::Equal)
        }).unwrap_or(1_000.0);
        let bar_px = ((nice_m / mpp).round() as i32).clamp(8, 240);

        // Human-readable label: "500 m" / "5 km"
        let label = if nice_m < 1_000.0 {
            format!("{} m", nice_m as u32)
        } else {
            format!("{} km", (nice_m / 1_000.0) as u32)
        };
        let label_px = label.len() as i32 * 6; // FONT_6X12 = 6 px wide

        let bar_y  = MAP_Y_BOT - 8;
        // Shifted right by 1/5 of the screen so it clears the Google logo / labels.
        let bar_x1 = 8 + SCREEN_W / 5;
        let bar_x2 = bar_x1 + bar_px;

        // Dark background box covering label + bar
        let bg_w = (bar_x2 - bar_x1 + 4).max(label_px + 4);
        fill(display, bar_x1 - 2, bar_y - 16, bg_w, 21, Rgb565::new(2, 4, 2));

        // Bar line + end ticks
        let wh = PrimitiveStyle::with_stroke(Rgb565::WHITE, 1);
        let _ = Line::new(Point::new(bar_x1, bar_y), Point::new(bar_x2, bar_y)).into_styled(wh).draw(display);
        let _ = Line::new(Point::new(bar_x1, bar_y - 3), Point::new(bar_x1, bar_y + 2)).into_styled(wh).draw(display);
        let _ = Line::new(Point::new(bar_x2, bar_y - 3), Point::new(bar_x2, bar_y + 2)).into_styled(wh).draw(display);

        // Centred label above the bar
        let label_x = (bar_x1 + (bar_px - label_px) / 2).max(0);
        text(display, &label, label_x, bar_y - 4, &FONT_6X12, Rgb565::WHITE);
    }

    // ── Text band under the map: two columns of two rows ─────────────────────
    fill(display, 0, TEXT_Y, SCREEN_W, SCREEN_H - TEXT_Y, Rgb565::BLACK);
    let (l1, l2, l3, l4, c1);
    let zoom = crate::map_display::get_zoom();
    if let Some(e) = eew.as_ref() {
        // Active EEW takes priority over everything else.
        c1 = Rgb565::RED;
        l1 = format!("EEW {} Imax {} {}", fmt_mag(e.mag), e.intensity(), fmt_depth(e.depth));
        l2 = crate::place::describe(e.lat, e.lon);
        l3 = if e.lat.is_nan() { "Epicenter unknown".to_string() } else { format!("{} Z{}", fmt_latlon(e.lat, e.lon), zoom) };
        l4 = format!("Issued {}", e.time.get(11..19).unwrap_or(&e.time));
    } else if let Some(q) = newq.as_ref() {
        c1 = Rgb565::YELLOW;
        l1 = format!("NEW {} Imax {} {}", fmt_mag(q.mag), q.intensity(), fmt_depth(q.depth));
        l2 = crate::place::describe(q.lat, q.lon);
        l3 = format!("{} Z{}", fmt_latlon(q.lat, q.lon), zoom);
        l4 = format!("{} {}", q.time.get(5..16).unwrap_or(&q.time), tsunami_short(&q.tsunami));
    } else if let Some(p) = prompt.as_ref() {
        // 震度速報: intensity known, epicenter not yet (area names are Japanese:
        // the ASCII font can't show them, the Web UI does).
        c1 = Rgb565::CSS_ORANGE;
        l1 = format!("SHINDO REPORT Imax {}", p.intensity());
        l2 = "Epicenter: pending".to_string();
        l3 = format!("{} area(s) at Imax", p.areas.len());
        l4 = format!("Quake {}", p.time.get(11..19).unwrap_or(&p.time));
    } else if let Some(q) = quake_focus.and_then(|(fl, fo)| {
        crate::quake::get().into_iter().find(|q| (q.lat - fl).abs() < 1e-6 && (q.lon - fo).abs() < 1e-6)
    }) {
        c1 = Rgb565::CSS_CYAN;
        l1 = format!("{} Imax {} {}", fmt_mag(q.mag), q.intensity(), fmt_depth(q.depth));
        l2 = crate::place::describe(q.lat, q.lon);
        l3 = format!("{} Z{}", fmt_latlon(q.lat, q.lon), zoom);
        l4 = format!("{} {}", q.time.get(5..16).unwrap_or(&q.time), tsunami_short(&q.tsunami));
    } else {
        c1 = Rgb565::CSS_LIGHT_GREEN;
        let quakes = crate::quake::get();
        l1 = "Japan overview".to_string();
        l2 = format!("Zoom {}  Quakes {}", zoom, quakes.len());
        l3 = match quakes.first() {
            Some(q) => format!("Latest {} {} I{}", q.time.get(5..16).unwrap_or(&q.time), fmt_mag(q.mag), q.intensity()),
            None => if !crate::quake::enabled() { "Quake feed disabled".to_string() }
                    else if crate::quake::last_ok_secs() == 0 { "Waiting for quake data".to_string() }
                    else { "No events".to_string() },
        };
        l4 = String::new();
    }
    text(display, &l1, TEXT_COL_X[0], TEXT_Y + 14, &FONT_8X13, c1);
    text(display, &l2, TEXT_COL_X[0], TEXT_Y + 30, &FONT_8X13, Rgb565::WHITE);
    text(display, &l3, TEXT_COL_X[1], TEXT_Y + 14, &FONT_8X13, Rgb565::WHITE);
    text(display, &l4, TEXT_COL_X[1], TEXT_Y + 30, &FONT_8X13, Rgb565::WHITE);

    // ── One-line top bar: title, button legend (battery is drawn by the caller) ──
    fill(display, 0, 0, SCREEN_W, MAP_BAR_H, Rgb565::BLACK);
    let (title, tcol) = if let Some(e) = eew.as_ref() {
        (format!("!! EEW M{:.1} I{} !!", e.mag.max(0.0), e.intensity()), Rgb565::RED)
    } else if let Some(q) = newq.as_ref() {
        (format!("NEW QUAKE M{:.1} I{}", q.mag.max(0.0), q.intensity()), Rgb565::YELLOW)
    } else if let Some(p) = prompt.as_ref() {
        (format!("SHINDO {} (no epicenter yet)", p.intensity()), Rgb565::CSS_ORANGE)
    } else {
        (format!("MAP {}/{}", PAGE_MAP + 1, PAGE_COUNT), Rgb565::CSS_LIGHT_GREEN)
    };
    text(display, &title, 4, 15, &FONT_8X13, tcol);
    let legend: &[Legend] = if eew.is_some() || newq.is_some() {
        &[Legend::Page("EXIT"), Legend::Up, Legend::Down, Legend::Action("TYPE")]
    } else {
        &[Legend::Page("PAGE"), Legend::Up, Legend::Down, Legend::Action("TYPE")]
    };
    draw_legend(display, 190, 15, legend);
    true
}

fn tsunami_short(t: &str) -> &'static str {
    match t {
        "Watch" | "Warning" => "TSUNAMI!",
        "Checking" => "tsunami: checking",
        _ => "",
    }
}

// ─── Earthquake page ─────────────────────────────────────────────────────
//
// Recent earthquakes from the P2P地震情報 API (see quake.rs), one line per
// event (time/M/intensity/depth, epicenter coordinates, tsunami flag) and a
// details line for the highlighted one; the font is ASCII-only, so the
// Japanese hypocenter name is shown on the Web UI only. +UP/-DOWN move the
// highlight, the red button centres the MAP page on the highlighted epicenter
// — see btn_ctrl.rs.

const QUAKE_STATUS_Y: i32 = HEADER_H + 1;
const QUAKE_STATUS_H: i32 = 24;
const QUAKE_ROW_Y: i32 = QUAKE_STATUS_Y + QUAKE_STATUS_H;
const QUAKE_ROW_H: i32 = 28;
/// List rows visible at once; longer lists scroll to keep the highlight in view.
const QUAKE_ROWS: usize = 8;
const QUAKE_DETAIL_Y: i32 = QUAKE_ROW_Y + QUAKE_ROWS as i32 * QUAKE_ROW_H + 2;

/// Index of the first visible list row.
static QUAKE_TOP: core::sync::atomic::AtomicUsize = core::sync::atomic::AtomicUsize::new(0);

pub(crate) fn draw_quake_page<D: DrawTarget<Color = Rgb565>>(
    display: &mut D,
    force: bool,
    prev_slots: &mut Vec<String>,
) {
    let quakes = crate::quake::get();
    let sel = crate::quake::selection().min(quakes.len().saturating_sub(1));

    // Scroll just enough to keep the highlighted row visible.
    let mut top = QUAKE_TOP.load(Ordering::Relaxed).min(quakes.len().saturating_sub(QUAKE_ROWS));
    if sel < top { top = sel; }
    if sel >= top + QUAKE_ROWS { top = sel + 1 - QUAKE_ROWS; }
    QUAKE_TOP.store(top, Ordering::Relaxed);

    // Each slot is redrawn only when its signature string changes:
    // [0] status line, [1..=QUAKE_ROWS] list rows, [QUAKE_ROWS+1] details line.
    let n_slots = QUAKE_ROWS + 2;
    let mut sigs: Vec<String> = Vec::with_capacity(n_slots);

    let feed = if !crate::quake::enabled() { "feed off" }
               else if crate::quake::ws_connected() { "live" }
               else if crate::quake::last_ok_secs() == 0 { "waiting" }
               else { "polling" };
    let prompt = crate::quake::prompt();
    sigs.push(if let Some(p) = prompt.as_ref() {
        // 震度速報 waiting for its epicenter report.
        format!("SHINDO Imax {} at {}, epicenter pending", p.intensity(), p.time.get(11..16).unwrap_or(&p.time))
    } else if quakes.is_empty() {
        format!("Recent quakes: 0  [{}]", feed)
    } else {
        format!("Recent quakes: {}  [{}]  #{}/{}", quakes.len(), feed, sel + 1, quakes.len())
    });

    for i in 0..QUAKE_ROWS {
        sigs.push(match quakes.get(top + i) {
            Some(q) => format!("{}|{}|{}|{}|{}|{}|{:.2}|{:.2}|{}", top + i == sel, top + i, q.time, q.mag, q.scale, q.depth, q.lat, q.lon, q.tsunami),
            None if i == 0 && quakes.is_empty() => {
                let msg = if !crate::quake::enabled() { "(disabled: set quake_enable in cfg.toml)" }
                          else if crate::quake::last_ok_secs() == 0 { "(waiting for data...)" } else { "(no events)" };
                format!("msg|{}", msg)
            }
            None => String::new(),
        });
    }
    sigs.push(match quakes.get(sel) {
        Some(q) => format!("{}|{}|{}|{}|{:.2}|{:.2}|{}", q.time, q.mag, q.scale, q.depth, q.lat, q.lon, q.tsunami),
        None => String::new(),
    });

    let changed = |i: usize| force || prev_slots.len() != sigs.len() || prev_slots[i] != sigs[i];

    // Status line
    if changed(0) {
        fill(display, 0, QUAKE_STATUS_Y, SCREEN_W, QUAKE_STATUS_H, Rgb565::BLACK);
        let col = if prompt.is_some() { Rgb565::CSS_ORANGE } else { Rgb565::CSS_LIGHT_GREEN };
        text(display, &sigs[0], 4, QUAKE_STATUS_Y + 17, &FONT_8X13, col);
        if prompt.is_none() {
            text(display, "JMA via P2P", SCREEN_W - 11 * INFO_CHAR_W - 4, QUAKE_STATUS_Y + 17, &FONT_8X13, DIM);
        }
    }

    // List rows
    for i in 0..QUAKE_ROWS {
        if !changed(1 + i) { continue; }
        let y = QUAKE_ROW_Y + i as i32 * QUAKE_ROW_H;
        let selected = top + i == sel && top + i < quakes.len();
        fill(display, 0, y, SCREEN_W, QUAKE_ROW_H, if selected { SEL_BG } else { Rgb565::BLACK });
        match quakes.get(top + i) {
            Some(q) => {
                let col = quake_color(q.scale, q.mag);
                if selected { fill(display, 0, y, 3, QUAKE_ROW_H, col); }
                let t = q.time.get(5..16).unwrap_or(&q.time); // "10/10 10:20"
                let l1 = format!("{} {} I{} {}", t, fmt_mag(q.mag), q.intensity(), fmt_depth(q.depth));
                text(display, &l1, 8, y + 21, &FONT_10X20, col);
                text(display, &fmt_latlon(q.lat, q.lon), 290, y + 19, &FONT_8X13, DIM);
                let tsu = tsunami_short(&q.tsunami);
                if !tsu.is_empty() {
                    text(display, "TSUNAMI!", SCREEN_W - 8 * INFO_CHAR_W - 4, y + 19, &FONT_8X13, Rgb565::CSS_ORANGE);
                }
            }
            None => {
                if let Some(msg) = sigs[1 + i].strip_prefix("msg|") {
                    text(display, msg, 8, y + 19, &FONT_8X13, DIM);
                }
            }
        }
    }

    // Details of the highlighted event
    if changed(n_slots - 1) {
        let h = LEGEND_Y - QUAKE_DETAIL_Y;
        fill(display, 0, QUAKE_DETAIL_Y, SCREEN_W, h, Rgb565::BLACK);
        fill(display, 0, QUAKE_DETAIL_Y - 1, SCREEN_W, 1, Rgb565::CSS_DARK_GREEN);
        if let Some(q) = quakes.get(sel) {
            let l = format!("{} Imax {} Depth {} {} Tsu:{}",
                fmt_mag(q.mag), q.intensity(), fmt_depth(q.depth), fmt_latlon(q.lat, q.lon), q.tsunami);
            text(display, &l, 4, QUAKE_DETAIL_Y + 14, &FONT_8X13, quake_color(q.scale, q.mag));
        }
    }
    *prev_slots = sigs;

    if force {
        draw_legend_row(display, &[Legend::Page("PAGE"), Legend::Up, Legend::Down, Legend::Action("MAP")], SCREEN_W);
    }
}

// ─── Info page ───────────────────────────────────────────────────────────

pub(crate) fn draw_info_page<D: DrawTarget<Color = Rgb565>>(
    display: &mut D,
    force: bool,
    prev_lines: &mut Vec<String>,
) {
    let st = |c: Rgb565| MonoTextStyleBuilder::new().font(&FONT_8X13).text_color(c).build();
    let section_style = st(Rgb565::CSS_LIGHT_GREEN);
    let label_style = st(CYAN);
    let val_style = st(Rgb565::WHITE);
    let val_yellow = st(Rgb565::YELLOW);
    let val_on = st(Rgb565::GREEN);
    let val_off = st(Rgb565::new(21, 0, 0));  // dim red
    let val_disabled = st(DIM);

    // Collect data
    let (ip, ssid, rssi, battery, chip_temp) = {
        let guard = DISPLAY_AUX.lock().unwrap();
        if let Some(ref aux) = *guard {
            let ip = aux.status.ip_address.lock().unwrap().clone();
            let ssid = aux.status.ssid.lock().unwrap().clone();
            let rssi = *aux.status.rssi.lock().unwrap();
            let battery = *aux.status.battery_voltage.lock().unwrap();
            let chip_temp = *aux.status.chip_temp.lock().unwrap();
            (ip, ssid, rssi, battery, chip_temp)
        } else {
            ("--".into(), "--".into(), 0i32, 0.0f32, 0.0f32)
        }
    };

    // Each line: Vec<(text, style_index)>
    // style_index: 0=section, 1=label, 2=val, 3=yellow, 4=on, 5=off, 6=disabled
    type Seg = (String, u8);
    // Two columns: left = network / power / memory, right = quake feed / display / firmware.
    let mut left: Vec<Vec<Seg>> = Vec::new();
    let mut right: Vec<Vec<Seg>> = Vec::new();

    // ── WiFi / Network ───────────────────
    left.push(vec![("-- Network --".into(), 0)]);
    left.push(vec![("IP:   ".into(), 1), (ip.clone(), 3)]);
    left.push(vec![("WiFi: ".into(), 1), (ssid.chars().take(20).collect::<String>(), 2)]);
    left.push(vec![
        ("RSSI: ".into(), 1),
        (format!("{}dBm", rssi), if rssi > -60 { 4 } else if rssi > -80 { 3 } else { 5 }),
    ]);

    // ── Power / chip ─────────────────────
    left.push(vec![("-- Power --".into(), 0)]);
    left.push(vec![("Battery:  ".into(), 1), (format!("{:.2}V", battery), 3)]);
    left.push(vec![
        ("ChipTemp: ".into(), 1),
        (format!("{:.1}C", chip_temp),
         if chip_temp < 70.0 { 4 } else if chip_temp < 85.0 { 3 } else { 5 }),
    ]);

    // ── Memory ───────────────────────────
    let mem = crate::httpserver::mem_info();
    left.push(vec![("-- Memory --".into(), 0)]);
    left.push(vec![
        ("Int:   ".into(), 1), (format!("{}KB", mem.int_free / 1024), 4),
        (" min ".into(), 1), (format!("{}KB", mem.int_min / 1024), 2),
    ]);
    left.push(vec![
        ("PSRAM: ".into(), 1), (format!("{}KB", mem.psram_free / 1024), 4),
        (" min ".into(), 1), (format!("{}KB", mem.psram_min / 1024), 2),
    ]);

    // ── Earthquake feed ──────────────────
    right.push(vec![("-- Earthquake feed --".into(), 0)]);
    if crate::quake::enabled() {
        let ws = crate::quake::ws_connected();
        right.push(vec![
            ("P2P WebSocket: ".into(), 1),
            (if ws { "connected".into() } else { "polling".into() }, if ws { 4 } else { 3 }),
        ]);
        right.push(vec![("Events: ".into(), 1), (format!("{}", crate::quake::get().len()), 2)]);
        right.push(vec![
            ("Maps API key: ".into(), 1),
            if crate::map_display::has_api_key() { ("set".into(), 4) } else { ("NOT SET".into(), 5) },
        ]);
    } else {
        right.push(vec![("disabled (quake_enable)".into(), 6)]);
    }

    // ── Display ──────────────────────────
    right.push(vec![("-- Display --".into(), 0)]);
    right.push(vec![("ILI9488 ".into(), 1), ("480x320 SPI".into(), 2)]);

    // ── Firmware ─────────────────────────
    right.push(vec![("-- Firmware --".into(), 0)]);
    right.push(vec![("Ver:   ".into(), 1), (crate::httpserver::FW_VERSION.to_string(), 3)]);
    right.push(vec![("Build: ".into(), 1), (crate::httpserver::FW_BUILD.to_string(), 2)]);

    // ── Draw, skipping rows whose text did not change ────────────────────────
    const COL_X: [i32; 2] = [0, 216];
    let max_rows = ((LEGEND_Y - HEADER_H - 2) / INFO_ROW_H) as usize;
    let mut text_strs: Vec<String> = Vec::new();
    for (ci, rows) in [&left, &right].into_iter().enumerate() {
        for (i, segs) in rows.iter().enumerate() {
            let line: String = segs.iter().map(|(t, _)| t.as_str()).collect();
            let idx = text_strs.len();
            text_strs.push(line);
            if i >= max_rows { continue; }
            let changed = force || idx >= prev_lines.len() || prev_lines[idx] != text_strs[idx];
            if !changed { continue; }

            let y = HEADER_H + 2 + (i as i32) * INFO_ROW_H;
            fill(display, COL_X[ci], y, if ci == 0 { 216 } else { SCREEN_W - 216 }, INFO_ROW_H, Rgb565::BLACK);

            if segs.len() == 1 && segs[0].1 == 0 {
                fill(display, COL_X[ci], y, if ci == 0 { 212 } else { SCREEN_W - 220 }, 1, Rgb565::new(0, 15, 0));
            }

            let mut x = COL_X[ci] + 4;
            for (t, sty) in segs {
                let style = match sty {
                    0 => section_style,
                    1 => label_style,
                    3 => val_yellow,
                    4 => val_on,
                    5 => val_off,
                    6 => val_disabled,
                    _ => val_style,
                };
                let _ = Text::new(t, Point::new(x, y + 14), style).draw(display);
                x += t.len() as i32 * INFO_CHAR_W;
            }
        }
    }
    *prev_lines = text_strs;

    if force {
        draw_legend_row(display, &[Legend::Page("PAGE")], SCREEN_W);
    }
}

// ─── Idle clock ──────────────────────────────────────────────────────────

/// Full-screen analog clock (JST) for the idle state. `unix_secs` is the
/// current UTC time; before the clock is set (NTP) only the face is drawn.
/// The dial is as large as the panel allows (diameter = screen height).
///
/// Drawn into an off-screen RGB888 canvas with real alpha blending (gradient
/// face, metallic bezel, soft drop shadows, bevel highlights), then copied to
/// the display in one piece. Light comes from the top-left.
pub(crate) fn draw_clock<D: DrawTarget<Color = Rgb565>>(display: &mut D, unix_secs: u64) {
    const D_: i32 = SCREEN_H;                 // canvas = dial square
    const X0: i32 = (SCREEN_W - D_) / 2;
    let (cx, cy) = (SCREEN_W as f32 / 2.0 - 0.5, SCREEN_H as f32 / 2.0 - 0.5);
    let r_out = SCREEN_H as f32 / 2.0 - 1.5;  // bezel outer edge
    let r_face = r_out - 9.0;                 // bezel inner edge / face

    let accent: Rgb = [255.0, 92.0, 24.0];    // 12/3/6/9 marks, second hand
    let tick: Rgb = [215.0, 218.0, 225.0];
    let dot: Rgb = [105.0, 110.0, 120.0];
    let hour_col: Rgb = [20.0, 200.0, 255.0]; // hour hand: cyan
    let min_col: Rgb = [242.0, 244.0, 248.0]; // minute hand: white

    let mut cv = Canvas::new(X0, 0, D_, D_);
    // pt(angle clockwise from 12, radius)
    let pt = |a: f32, r: f32| { let (s, c) = a.sin_cos(); (cx + r * s, cy - r * c) };

    // The dial (face, bezel, marks) never changes: render it once and reuse
    // it, so each second only the hands are drawn.
    let mut face = CLOCK_FACE.lock().unwrap();
    if let Some(px) = face.as_ref() {
        cv.px.copy_from_slice(px);
    } else {
        // ── Face (radial gradient) and bezel (metallic, lit from the top-left) ──
        for y in 0..D_ {
            for x in X0..X0 + D_ {
                let (dx, dy) = (x as f32 - cx, y as f32 - cy);
                let d = (dx * dx + dy * dy).sqrt();
                if d > r_out + 1.0 { continue; }
                let (ux, uy) = if d > 0.0 { (dx / d, dy / d) } else { (0.0, 0.0) };
                let lit = 0.5 - 0.5 * (ux * LIGHT.0 + uy * LIGHT.1); // 1 = facing the light
                let c = if d <= r_face {
                    let t = d / r_face;
                    let mut c = mix([44.0, 47.0, 54.0], [9.0, 10.0, 13.0], t * t);
                    // the raised bezel shades the inner rim on the lit side
                    let near = ((d - (r_face - 14.0)) / 14.0).clamp(0.0, 1.0);
                    let sh = near * near * (0.25 + 0.55 * lit);
                    c = mix(c, [0.0; 3], sh);
                    c
                } else {
                    // a rounded metal ring: brightest across its crown
                    let u = ((d - r_face) / (r_out - r_face)).clamp(0.0, 1.0);
                    let crown = (u * core::f32::consts::PI).sin();
                    let metal = mix([45.0, 47.0, 53.0], [228.0, 231.0, 238.0], lit);
                    mix([20.0, 21.0, 24.0], metal, 0.35 + 0.65 * crown)
                };
                let cov = (r_out + 0.5 - d).clamp(0.0, 1.0); // anti-aliased outer edge
                cv.blend(x, y, c, cov);
            }
        }

        // ── Dial marks ──
        for i in 0..60 {
            let a = i as f32 * core::f32::consts::PI / 30.0;
            if i % 15 == 0 {
                let (p, q) = (pt(a, r_face - 36.0), pt(a, r_face - 10.0));
                cv.raised(p, q, 5.0, accent, 3.0);
            } else if i % 5 == 0 {
                let (p, q) = (pt(a, r_face - 26.0), pt(a, r_face - 10.0));
                cv.raised(p, q, 3.0, tick, 2.5);
            } else {
                let p = pt(a, r_face - 10.0);
                cv.capsule(p, p, 1.5, 1.0, dot, 1.0);
            }
        }
        *face = Some(cv.px.clone());
    }
    drop(face);

    let synced = unix_secs >= 1_704_067_200; // 2024-01-01: the clock is set
    let t = unix_secs + 9 * 3600; // JST
    if synced {
        let (h, m, s) = ((t / 3600 % 24) as f32, (t / 60 % 60) as f32, (t % 60) as f32);
        let pi2 = core::f32::consts::PI * 2.0;
        let a_s = s / 60.0 * pi2;
        let a_m = (m + s / 60.0) / 60.0 * pi2;
        let a_h = ((h % 12.0) + m / 60.0) / 12.0 * pi2;

        // Hands: higher layers cast longer shadows
        cv.raised(pt(a_h, -16.0), pt(a_h, r_out * 0.50), 7.0, hour_col, 5.0);
        cv.raised(pt(a_m, -20.0), pt(a_m, r_out * 0.80), 5.0, min_col, 7.0);
        cv.raised(pt(a_s, -30.0), pt(a_s, r_out * 0.88), 1.6, accent, 9.0);

        // Centre cap: a domed metal button with an accent ring
        let c = (cx, cy);
        cv.capsule((cx + 9.0 * LIGHT.0, cy + 9.0 * LIGHT.1), (cx + 9.0 * LIGHT.0, cy + 9.0 * LIGHT.1), 9.0, 6.0, [0.0; 3], 0.6);
        cv.capsule(c, c, 10.0, 1.0, accent, 1.0);
        cv.capsule(c, c, 6.0, 1.0, [70.0, 72.0, 78.0], 1.0);
        let hl = (cx - 2.5 * LIGHT.0, cy - 2.5 * LIGHT.1);
        cv.capsule(hl, hl, 2.0, 3.0, [255.0; 3], 0.7);
    }

    // Black side bands, then the dial square
    fill(display, 0, 0, X0, SCREEN_H, Rgb565::BLACK);
    fill(display, X0 + D_, 0, SCREEN_W - X0 - D_, SCREEN_H, Rgb565::BLACK);
    let _ = display.fill_contiguous(
        &Rectangle::new(Point::new(X0, 0), Size::new(D_ as u32, D_ as u32)),
        cv.px.iter().map(|p| Rgb565::new(p[0] >> 3, p[1] >> 2, p[2] >> 3)),
    );

    // ── Date (JST) in the corners, outside the dial ──
    if synced {
        let days = (t / 86_400) as i64;
        let (y, mo, d) = civil_from_days(days);
        const WD: [&str; 7] = ["THU", "FRI", "SAT", "SUN", "MON", "TUE", "WED"]; // day 0 = 1970-01-01 Thu
        let wd = (days % 7) as usize;
        let yellow: Rgb = [255.0, 228.0, 50.0];
        let wd_col: Rgb = match wd {
            2 => [50.0, 178.0, 255.0], // Saturday: blue
            3 => [255.0, 82.0, 70.0],  // Sunday: red
            _ => yellow,
        };
        text_3d(display, &format!("{:02}/{:02}", mo, d), 6, 8, &CLOCK_FONT_L, 3, yellow);
        text_3d(display, &format!("{:04}", y), 8, 52, &CLOCK_FONT_S, 2, [200.0, 200.0, 200.0]);
        let w = aa_width(&CLOCK_FONT_L, WD[wd]);
        text_3d(display, WD[wd], SCREEN_W - 9 - w, 8, &CLOCK_FONT_L, 3, wd_col);
    }
}

include!("clock_font_data.rs");

/// Width in pixels of `s` in an [`AaFont`] (unknown characters are skipped).
fn aa_width(f: &AaFont, s: &str) -> i32 {
    s.chars().filter_map(|ch| f.glyphs.iter().find(|g| g.0 == ch)).map(|g| g.1).sum()
}

/// Text in an anti-aliased [`AaFont`], made to look extruded: darker copies
/// stacked down-right (`depth` px) give it thickness, the face has a
/// top-to-bottom gradient, a lit top-left edge and a shaded bottom-right edge.
/// (x, y) = top-left of the face; it is drawn on black.
fn text_3d<D: DrawTarget<Color = Rgb565>>(display: &mut D, s: &str, x: i32, y: i32, font: &AaFont, depth: i32, c: Rgb) {
    // Coverage map of the whole string
    let (w, h) = (aa_width(font, s), font.h);
    if w <= 0 { return; }
    let mut cov = vec![0f32; (w * h) as usize];
    let mut gx0 = 0;
    for ch in s.chars() {
        let Some(&(_, gw, data)) = font.glyphs.iter().find(|g| g.0 == ch) else { continue };
        for gy in 0..h { for gx in 0..gw {
            cov[(gy * w + gx0 + gx) as usize] = data[(gy * gw + gx) as usize] as f32 / 255.0;
        }}
        gx0 += gw;
    }
    let cv_at = |mx: i32, my: i32| if mx >= 0 && my >= 0 && mx < w && my < h { cov[(my * w + mx) as usize] } else { 0.0 };

    let mut cv = Canvas::new(x, y, w + depth, h + depth);
    // Extruded sides, back to front
    for k in (1..=depth).rev() {
        let side = mix(c, [0.0; 3], 0.55 + 0.1 * k as f32 / depth as f32);
        for my in 0..h { for mx in 0..w {
            let a = cv_at(mx, my);
            if a > 0.0 { cv.blend(x + mx + k, y + my + k, side, a); }
        }}
    }
    // Face, lit from the top-left using the slope of the coverage
    for my in 0..h { for mx in 0..w {
        let a = cv_at(mx, my);
        if a <= 0.0 { continue; }
        let t = my as f32 / (h - 1) as f32;
        let mut col = if t < 0.5 { mix(mix(c, [255.0; 3], 0.45), c, t * 2.0) }
                      else       { mix(c, mix(c, [0.0; 3], 0.2), (t - 0.5) * 2.0) };
        let gx = cv_at(mx + 1, my) - cv_at(mx - 1, my);
        let gy = cv_at(mx, my + 1) - cv_at(mx, my - 1);
        let l = (gx * LIGHT.0 + gy * LIGHT.1) * 0.5; // > 0: edge faces the light
        col = if l > 0.0 { mix(col, [255.0; 3], (l * 0.9).min(0.5)) } else { mix(col, [0.0; 3], (-l * 0.6).min(0.35)) };
        cv.blend(x + mx, y + my, col, a);
    }}
    let _ = display.fill_contiguous(&cv.bounding_box(),
        cv.px.iter().map(|p| Rgb565::new(p[0] >> 3, p[1] >> 2, p[2] >> 3)));
}

/// Cached dial of the idle clock (see [`draw_clock`]).
static CLOCK_FACE: Mutex<Option<Vec<[u8; 3]>>> = Mutex::new(None);

/// Direction the light travels (top-left → bottom-right), unit length.
const LIGHT: (f32, f32) = (0.6, 0.8);

type Rgb = [f32; 3];

fn mix(a: Rgb, b: Rgb, t: f32) -> Rgb {
    [a[0] + (b[0] - a[0]) * t, a[1] + (b[1] - a[1]) * t, a[2] + (b[2] - a[2]) * t]
}

/// Off-screen RGB888 canvas (screen coordinates) with alpha blending.
struct Canvas { x0: i32, y0: i32, w: i32, h: i32, px: Vec<[u8; 3]> }

impl Canvas {
    fn new(x0: i32, y0: i32, w: i32, h: i32) -> Self {
        Canvas { x0, y0, w, h, px: vec![[0u8; 3]; (w * h) as usize] }
    }

    fn blend(&mut self, x: i32, y: i32, c: Rgb, a: f32) {
        let (lx, ly) = (x - self.x0, y - self.y0);
        if a <= 0.0 || lx < 0 || ly < 0 || lx >= self.w || ly >= self.h { return; }
        let a = a.min(1.0);
        let p = &mut self.px[(ly * self.w + lx) as usize];
        for k in 0..3 {
            let v = p[k] as f32;
            p[k] = (v + (c[k] - v) * a).round().clamp(0.0, 255.0) as u8;
        }
    }

    /// Capsule (thick line with round ends) p→q, half-width `r`, edge
    /// softness `soft` px (1 = crisp anti-aliasing, larger = blurred shadow).
    fn capsule(&mut self, p: (f32, f32), q: (f32, f32), r: f32, soft: f32, c: Rgb, alpha: f32) {
        let (dx, dy) = (q.0 - p.0, q.1 - p.1);
        let len2 = (dx * dx + dy * dy).max(1e-6);
        let e = r + soft + 1.0;
        let (bx0, bx1) = ((p.0.min(q.0) - e).floor() as i32, (p.0.max(q.0) + e).ceil() as i32);
        let (by0, by1) = ((p.1.min(q.1) - e).floor() as i32, (p.1.max(q.1) + e).ceil() as i32);
        for y in by0.max(self.y0)..=by1.min(self.y0 + self.h - 1) {
            for x in bx0.max(self.x0)..=bx1.min(self.x0 + self.w - 1) {
                let (fx, fy) = (x as f32, y as f32);
                let t = (((fx - p.0) * dx + (fy - p.1) * dy) / len2).clamp(0.0, 1.0);
                let (ex, ey) = (fx - (p.0 + t * dx), fy - (p.1 + t * dy));
                let cov = ((r - (ex * ex + ey * ey).sqrt()) / soft + 0.5).clamp(0.0, 1.0);
                if cov > 0.0 { self.blend(x, y, c, cov * alpha); }
            }
        }
    }

    /// A raised bar: soft drop shadow (`height` px away from the light), the
    /// body, then a lit ridge on the light side and shade on the far side.
    fn raised(&mut self, p: (f32, f32), q: (f32, f32), r: f32, c: Rgb, height: f32) {
        let (sx, sy) = (height * LIGHT.0, height * LIGHT.1);
        self.capsule((p.0 + sx, p.1 + sy), (q.0 + sx, q.1 + sy), r, 1.0 + height * 0.8, [0.0; 3], 0.55);
        self.capsule(p, q, r, 1.0, c, 1.0);
        if r < 2.0 { return; }
        let (dx, dy) = (q.0 - p.0, q.1 - p.1);
        let l = (dx * dx + dy * dy).sqrt().max(1e-6);
        let (mut nx, mut ny) = (-dy / l, dx / l);
        if nx * LIGHT.0 + ny * LIGHT.1 > 0.0 { nx = -nx; ny = -ny; } // n points at the light
        let o = r * 0.45;
        self.capsule((p.0 + nx * o, p.1 + ny * o), (q.0 + nx * o, q.1 + ny * o), r * 0.4, 1.5, [255.0; 3], 0.38);
        self.capsule((p.0 - nx * o, p.1 - ny * o), (q.0 - nx * o, q.1 - ny * o), r * 0.4, 1.5, [0.0; 3], 0.28);
    }
}

impl Dimensions for Canvas {
    fn bounding_box(&self) -> Rectangle {
        Rectangle::new(Point::new(self.x0, self.y0), Size::new(self.w as u32, self.h as u32))
    }
}

impl DrawTarget for Canvas {
    type Color = Rgb565;
    type Error = core::convert::Infallible;
    fn draw_iter<I: IntoIterator<Item = Pixel<Rgb565>>>(&mut self, pixels: I) -> Result<(), Self::Error> {
        for Pixel(pt, c) in pixels {
            let rgb = [(c.r() as f32) * 255.0 / 31.0, (c.g() as f32) * 255.0 / 63.0, (c.b() as f32) * 255.0 / 31.0];
            self.blend(pt.x, pt.y, rgb, 1.0);
        }
        Ok(())
    }
}

/// Days since 1970-01-01 → (year, month, day), proleptic Gregorian.
fn civil_from_days(z: i64) -> (i64, u32, u32) {
    let z = z + 719_468;
    let era = z.div_euclid(146_097);
    let doe = z.rem_euclid(146_097);
    let yoe = (doe - doe / 1460 + doe / 36_524 - doe / 146_096) / 365;
    let doy = doe - (365 * yoe + yoe / 4 - yoe / 100);
    let mp = (5 * doy + 2) / 153;
    let d = (doy - (153 * mp + 2) / 5 + 1) as u32;
    let m = if mp < 10 { mp + 3 } else { mp - 9 } as u32;
    (yoe + era * 400 + if m <= 2 { 1 } else { 0 }, m, d)
}
