hnz1102/EEW-display/(commit log)

2026-10-19 Test-Bench version
    [partitions.csv]
2026-10-20 Add schematic data
    [BOM.csv, EEW-display.kicad_pcb, EEW-display.kicad_sch, bom.csv, designators.csv, positions.csv]
2026-10-26 Fix audio dropouts: defer WebSocket creation while speaking, add audio gap diagnostics
    Creating the WebSocket client during playback stalled the audio thread
    ~820 ms (DMA ring is 60 ms), heard as noise. Hold off creating it while
    a sentence plays; log the longest write gap per sentence.
    [audio.rs, quake.rs]
2026-10-26 Fixed Display Footprint and C1 capacitor value
    [BOM.csv, EEW-display.kicad_pcb, EEW-display.kicad_sch, bom.csv, positions.csv]
2026-10-26 Update Scheamtic
    [EEW-display.kicad_sch]
2026-11-04 Add idle analog clock as an alternative to backlight off (v0.3.0)
    New idle_mode setting (Web UI Display card / cfg.toml / NVS): when the
    screen_timeout expires, either switch the backlight off ("off", default)
    or show a full-screen analog clock in JST ("clock").
    - Clock rendered into an off-screen RGB888 canvas with alpha blending:
    metallic bezel, gradient dial, accent marks at 12/3/6/9, colour-coded
    hands with soft shadows and bevel highlights, all anti-aliased.
    - Date (month/day, year, weekday) outside the dial in extruded,
    anti-aliased glyphs pre-rendered from DejaVu Sans Condensed Bold
    (tools/clock_font/gen_clock_font.py -> src/clock_font_data.rs).
    - Static dial cached; the next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
2026-11-04 Add STL files and 3Ddata
    [base-v4.stl, body-v4.stl, button.stl, cover-v4.stl, eew-display.f3d]
2026-11-09 Announce 震度速報, harden WebSocket reception, add watchdog (v0.4.0)
    震度速報 (ScalePrompt) notification:
    - Announce the max intensity and up to four areas that observed it
    ("震度速報。最大震度3。最大震度を観測した地域は、…などです。") as soon as
    the report arrives, minutes before the epicenter report. Areas are
    spoken only when their full name is in the voice bank.
    - Orange "epicenter pending" band on the TFT map/quake pages, banner in
    the Web UI, "prompt" field in /api/quakes and a test-voice button.
    - Cleared when the epicenter report for the same quake arrives, or after
    15 minutes; stale (>20 min) or already-known quakes are ignored.
    - New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
2026-11-09 Update README for v0.4.0 (震度速報, WebSocket logging, health monitoring)
