hnz1102/EEW-display/(notices)

Notices in the files:
hw/EEW-display.kicad_sch:
Licensed under CC-BY-SA V4.0
(C) 2026 Hiroshi Nakajima
hw/EEW-display.kicad_pcb:
(C) 2026 HNZ EEW-DISPLAY R2
